Atmelfan/Kandidat/otiPSkB.gif

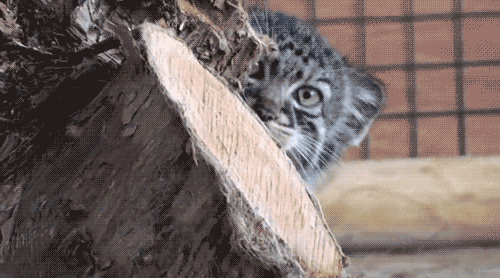
otiPSkB.gif
