Atmelfan/Kandidat/hbridge/hbridge_3d.PNG

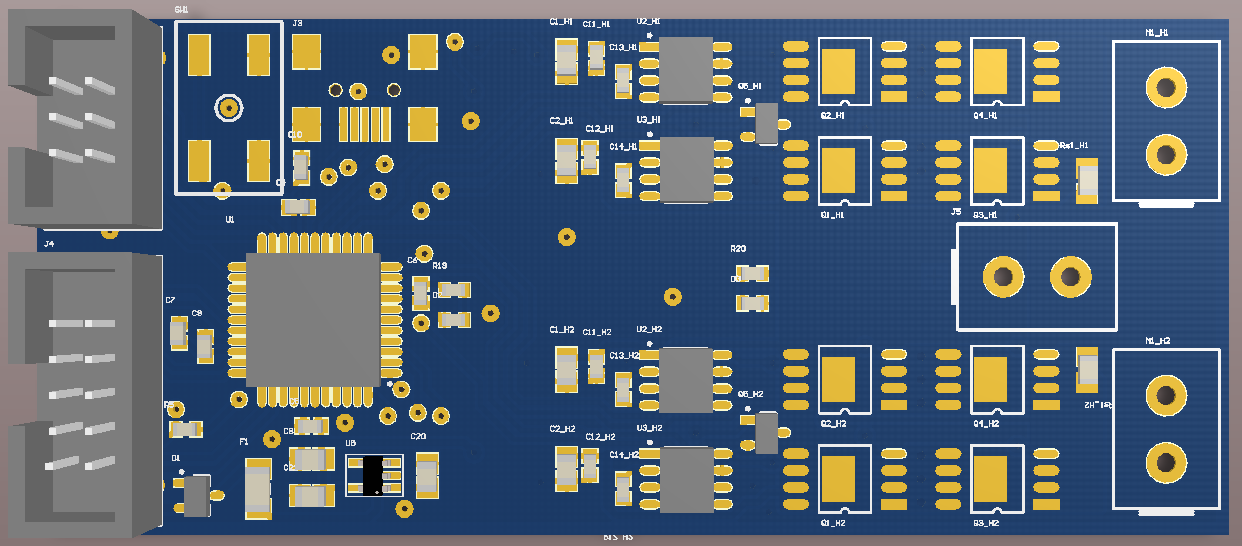
hbridge/hbridge_3d.PNG
