Atmelfan/Kandidat/Capabilities.pdf

## Fabrication limitations and design recommendations

Capability and recommendation matrix, ITN PCB laboratory
Detail | Minimum | Recommended | Maximum
Panel/Board size | Not relevant | < 160 x 160 mm | 210 x 300 mm

Width (conductors):
-Wire/trace | 0.25 mm | 0.5 mm | Not relevant
-Power wire | 0.25 mm | > 1.0 mm | Not relevant

Clearance (conductive):
-Generally | 0.25 mm | 0.6 mm | Not relevant
-Object - Polygon | | 1.0 mm

Other dimensions:
Annular ring VIA | 0.25 mm | >0.4 mm | Not relevant
Annular ring Component | 0.3 mm | >0.6 mm | Not relevant
Drill bit diameter | 0.4 mm | | 5.0 mm
Silkscreen to solder-mask | 0 mm | Not used
Solder mask sliver | 0.2 mm | >0.5 mm | Not relevant
Mill bit diameter | 1.0 mm | 1.5 mm | 2.5 mm
- “Generally means: Trace to trace, pad to pad, pad to trace, i.e., any conducting object that shouldn’t risk being short circuited.
- Object means; trace, pad, i.e., any object not belonging to a polygon plane.
- Annular ring = (diameter of the pad - diameter of the hole) / 2
- Silkscreen to solder-mask (clearance); is not an issue since we don’t print text on the PCB:s in the ITN PCB laboratory. Otherwise it is good to have 0.5 mm margins, and also possibly margins against component keep-out.
- Recommendations are not digital; always consider the particular design. E.g., if a thicker metal is used it is harder to etch small details (Small clearances). Moreover, it is also about probability. One narrow gap that is short is often not as likely as if there are several narrow gaps.
- Some component pads require tight margins, i.e., the footprint must suit the component and exceptions to the above might then be necessary.
- Drill bits are available in 0.1 mm steps, and mill bits are available in 0.5 mm steps. For drill-bits round off upwards if a component has an odd size.
