Atmelfan/Kandidat/hbridge/encoder_3d.png

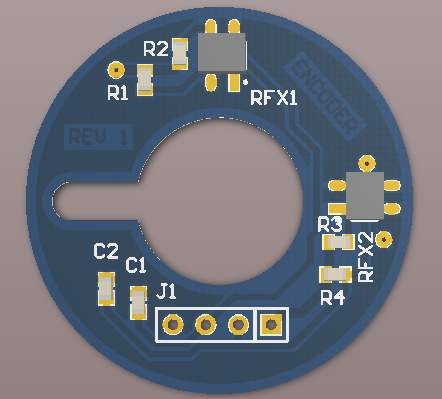
hbridge/encoder_3d.png
