Atmelfan/Kandidat/hbridge/figures/awex.png

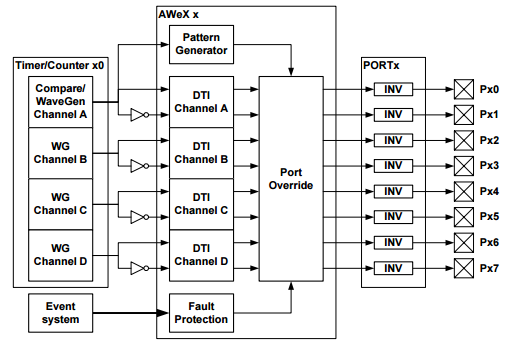
hbridge/figures/awex.png
