Atmelfan/Kandidat/hbridge/figures/bridge.PNG

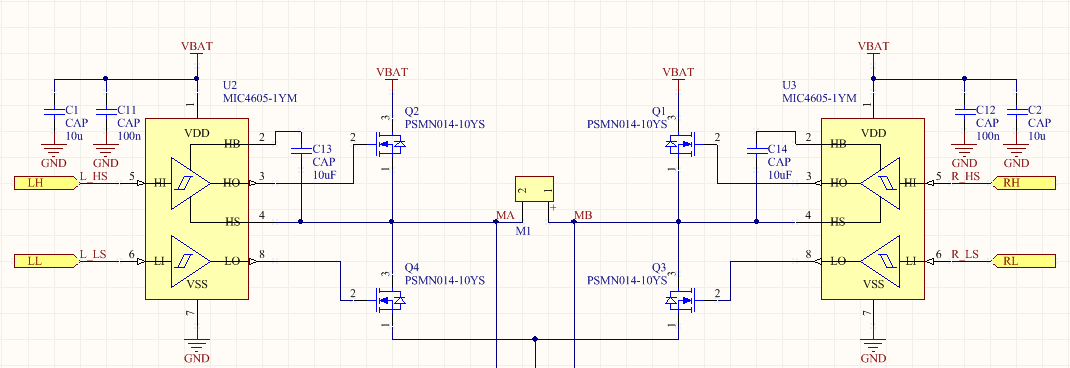
hbridge/figures/bridge.PNG
