Atmelfan/Kandidat/hbridge/figures/c_vs_v.PNG

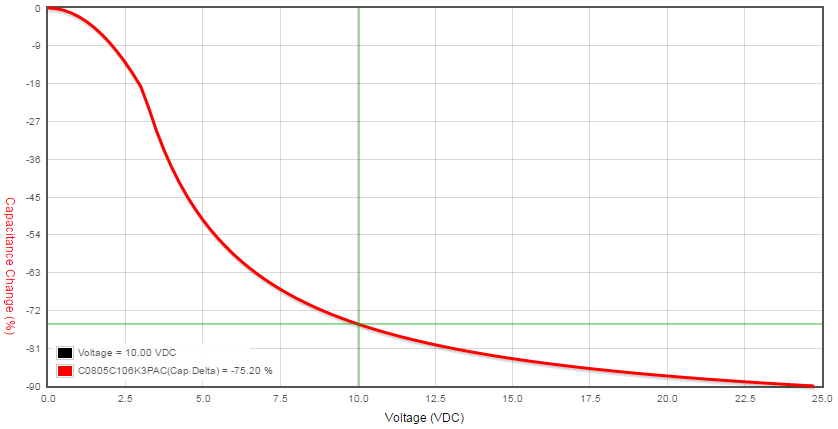
hbridge/figures/c_vs_v.PNG
