Atmelfan/Kandidat/hbridge/Hbridge_PCB_bot.PNG

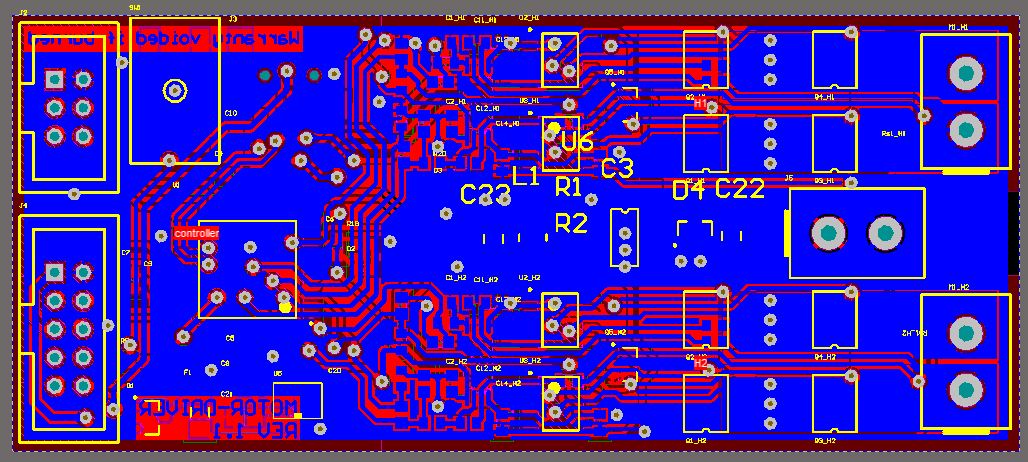
hbridge/Hbridge_PCB_bot.PNG
