Atmelfan/Kandidat/hbridge/Hbridge_PCB_top.PNG

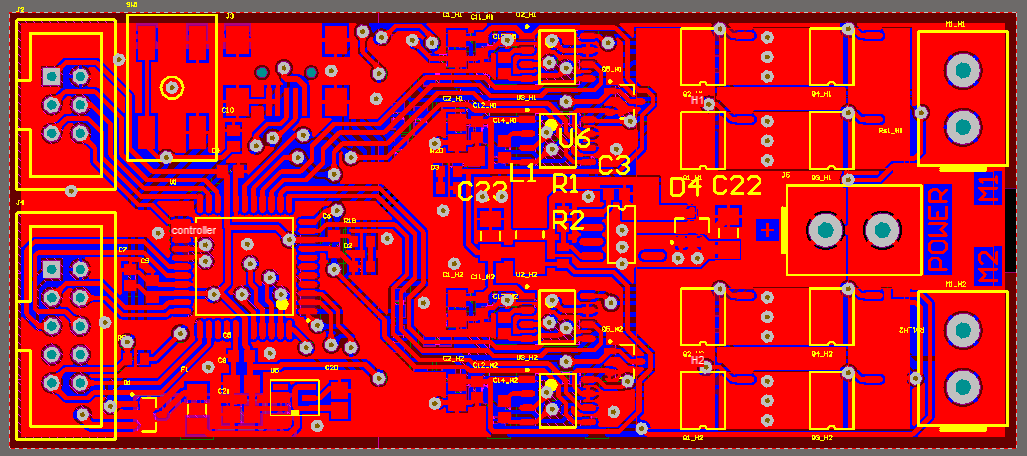
hbridge/Hbridge_PCB_top.PNG
