Atmelfan/Kandidat/hbridge/hbridge_schematic.PNG

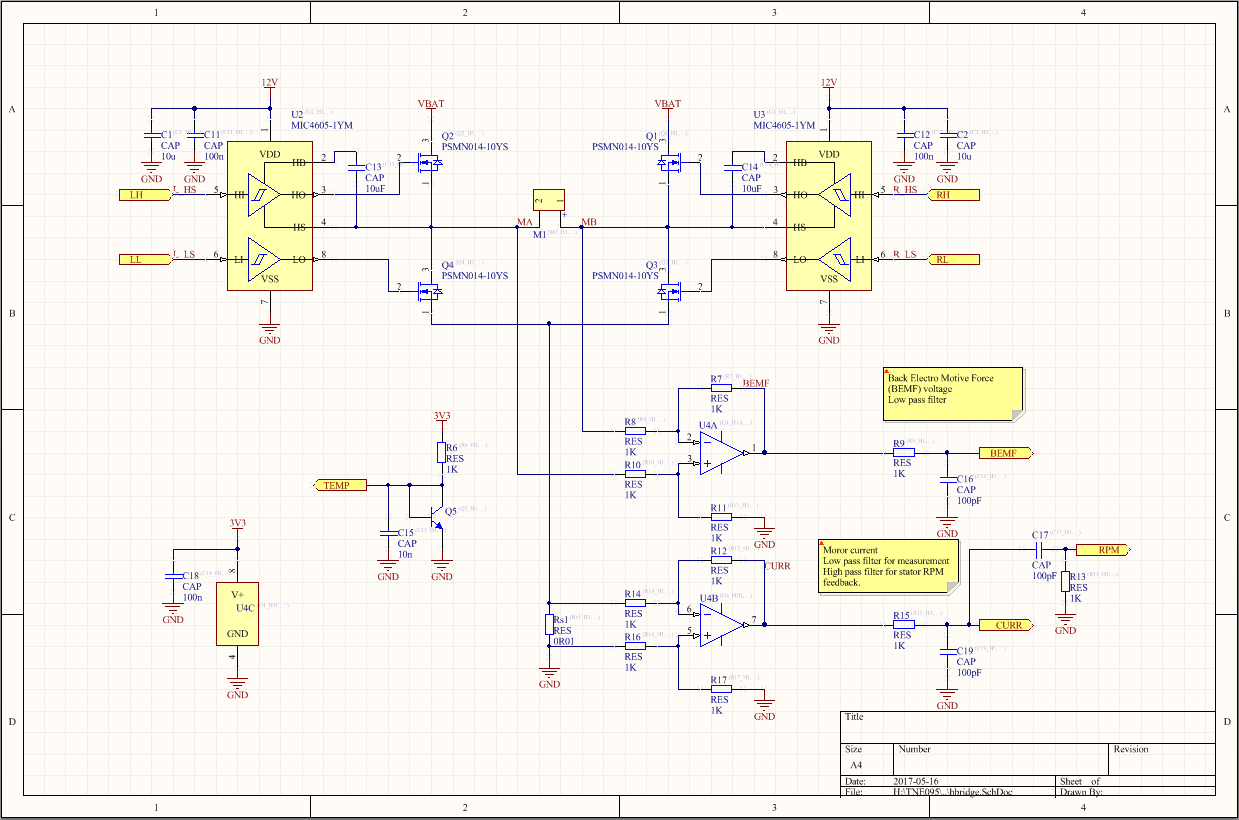
hbridge/hbridge_schematic.PNG
