Atmelfan/Kandidat/hbridge/motor_controller_schematic.PNG

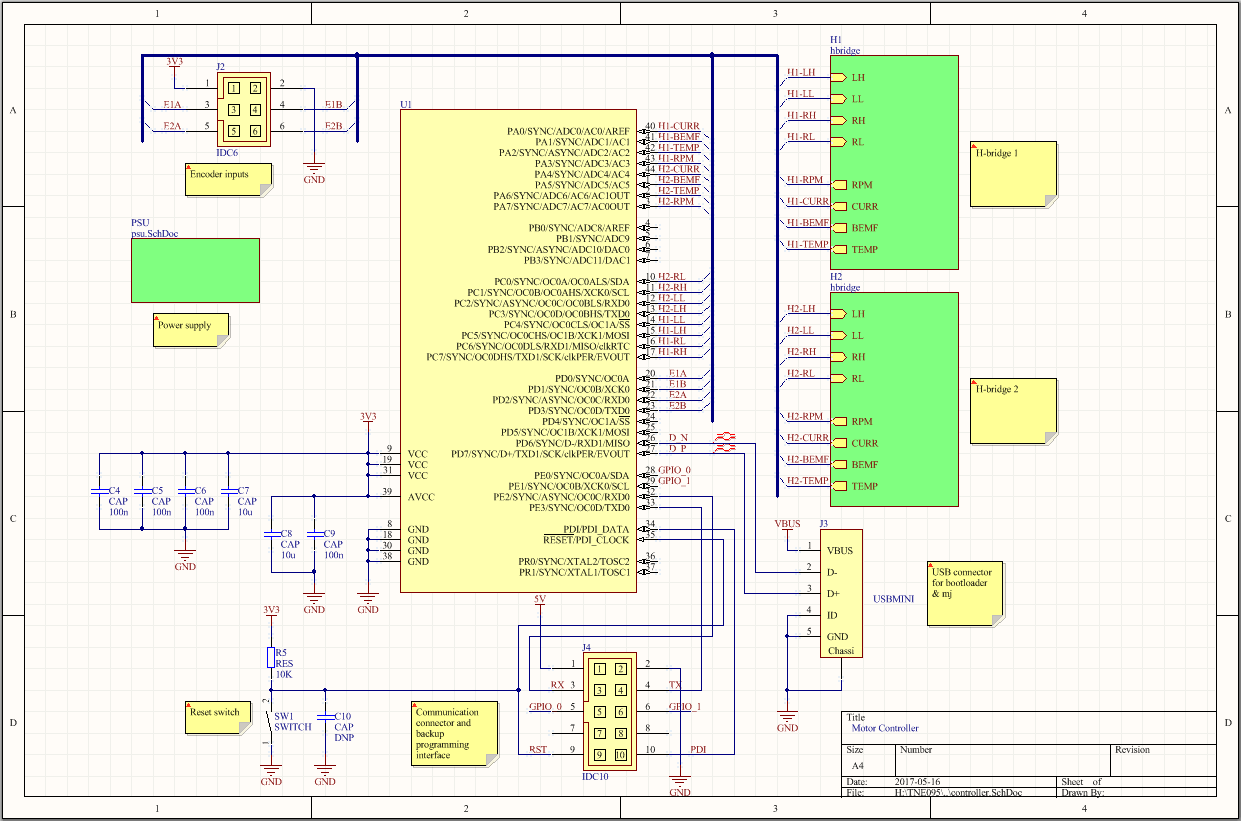
hbridge/motor_controller_schematic.PNG
