Atmelfan/Kandidat/hbridge/psu_schematic.PNG

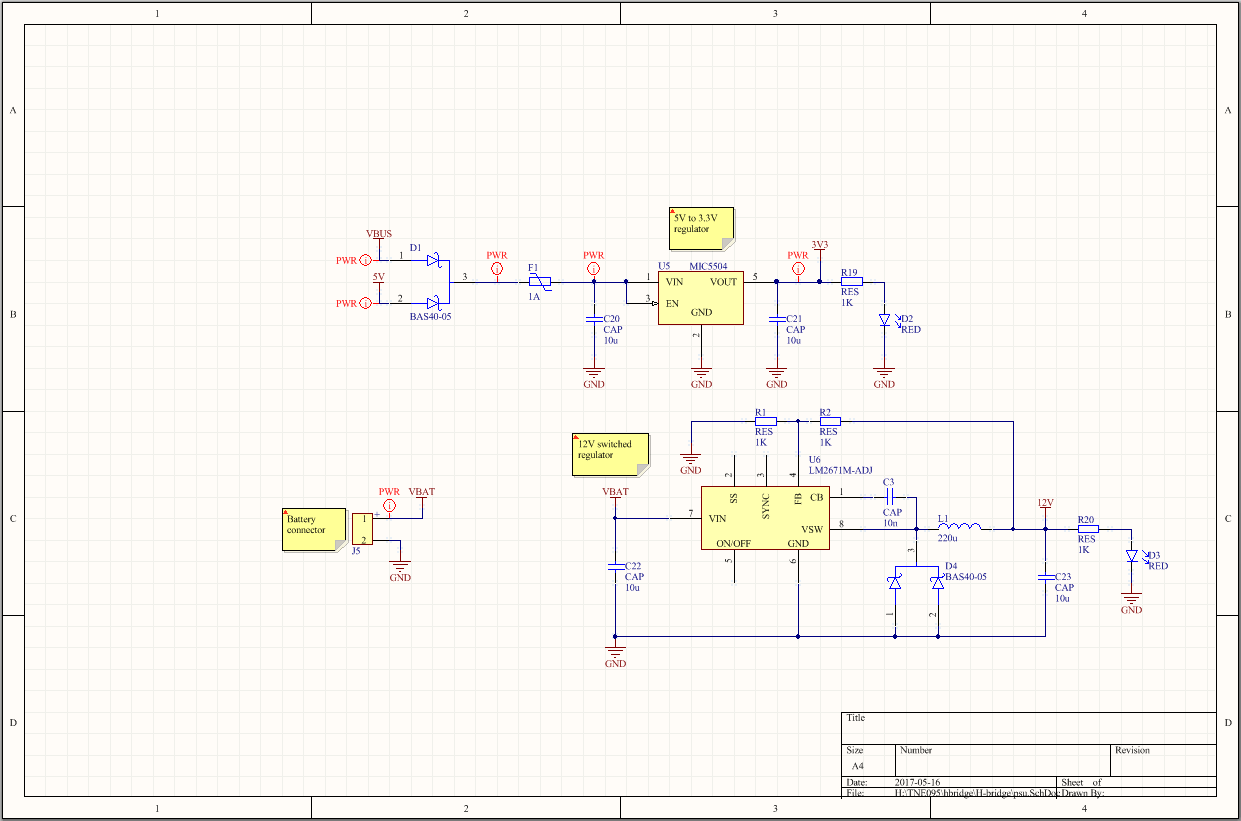
hbridge/psu_schematic.PNG
