Atmelfan/Kandidat/Passenger/Passenger_schematic.PNG

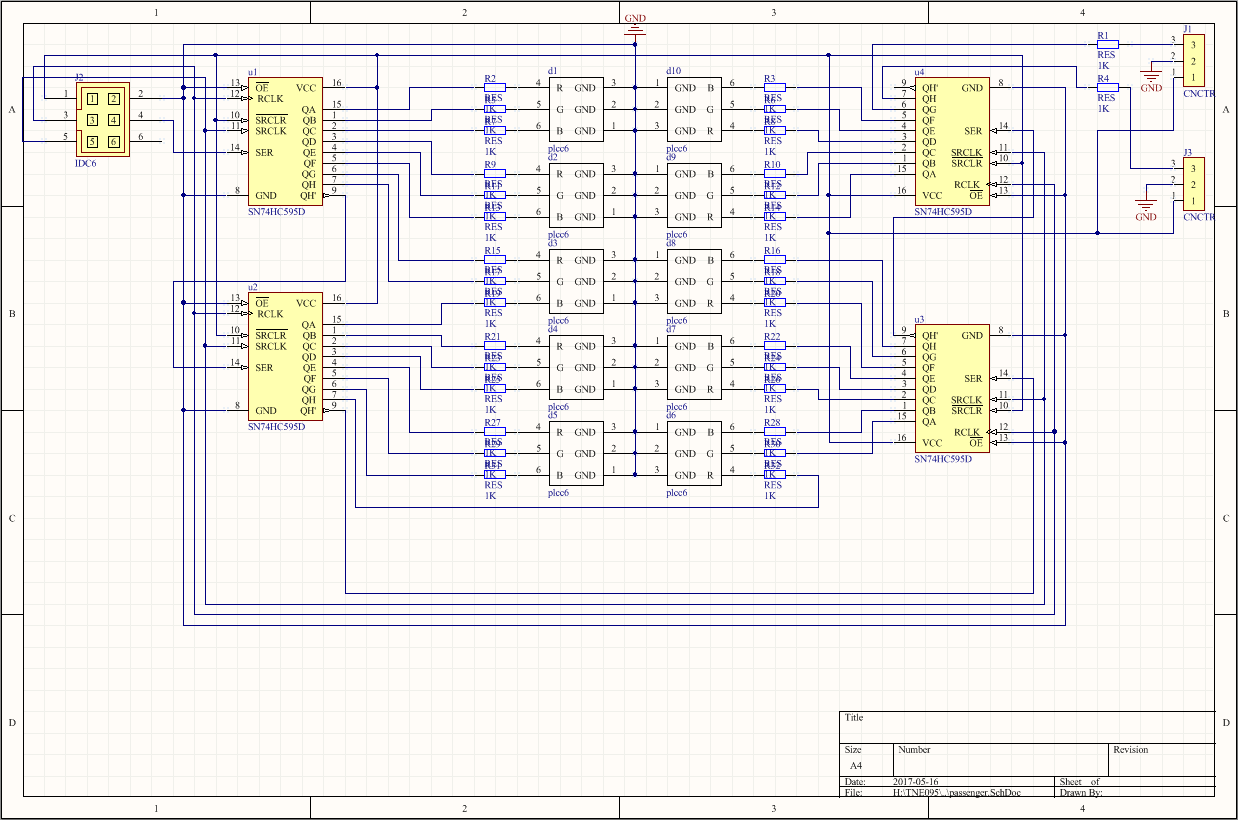
Passenger/Passenger_schematic.PNG
