Atmelfan/Kandidat/reflex/Reflex_PCB.PNG

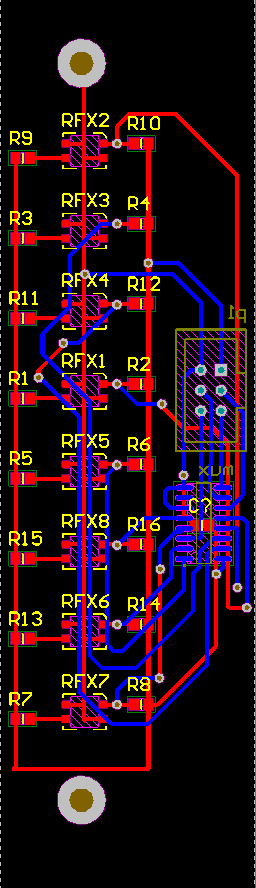
reflex/Reflex_PCB.PNG
