Atmelfan/Kandidat/reflex/Reflex_schematic.PNG

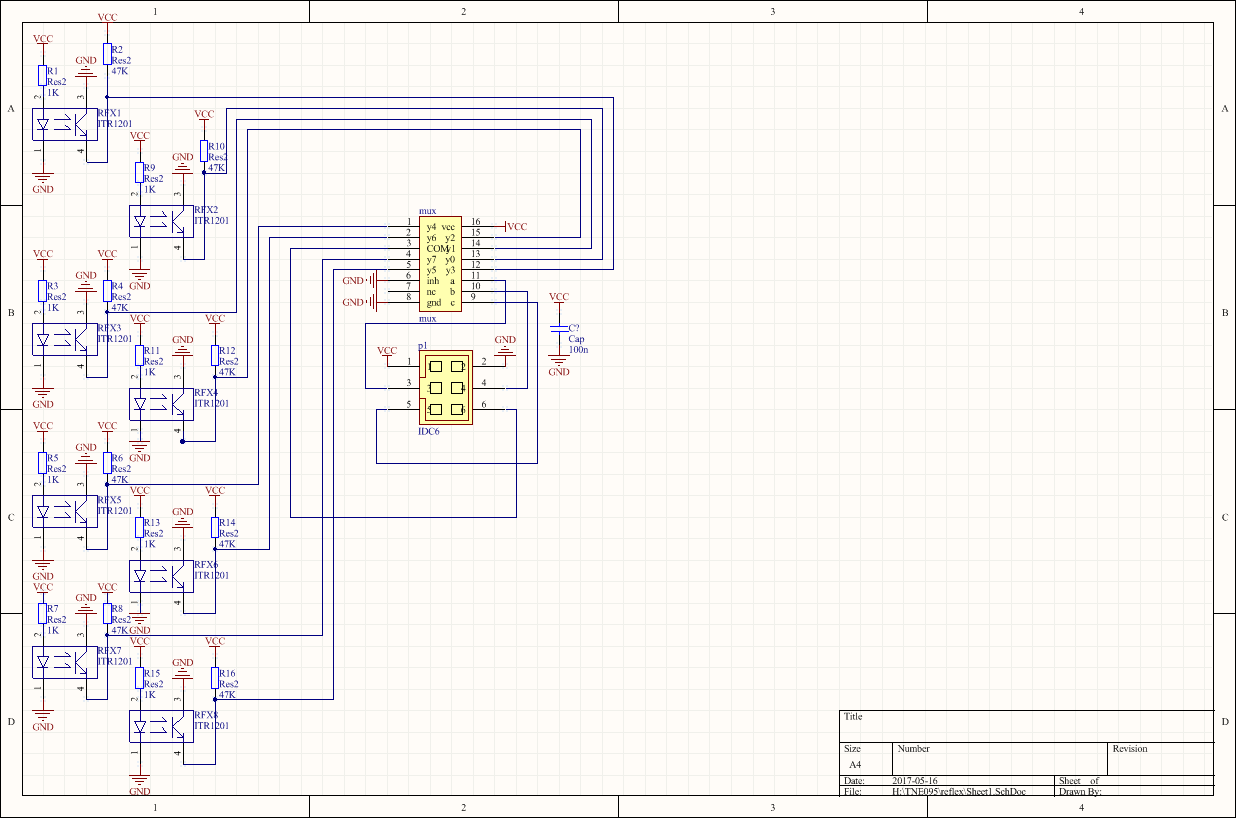
reflex/Reflex_schematic.PNG
