Atmelfan/Kandidat/titor.bmp

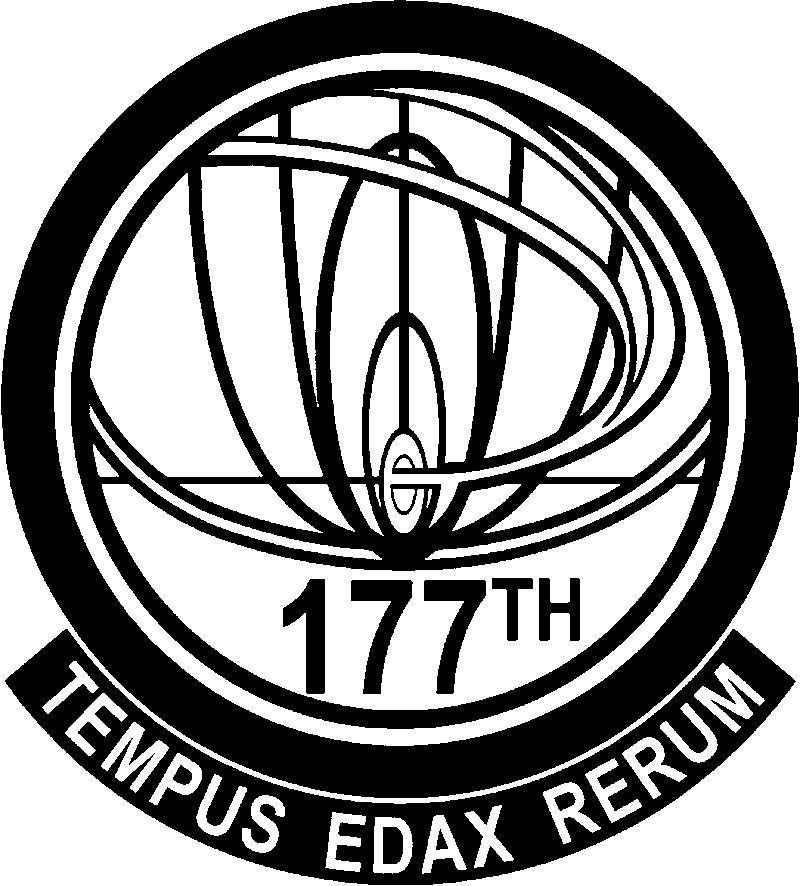
titor.bmp
