Atmelfan/Kandidat/ipc_cap.xls

Sheet: Data
Chip2PinSM | Package Specifications |  |  |  |  |  |  |  |  |  |  |  |  |  |  |  | Footprint Specifications
FootprintName | FootprintDescription | Lmin | Lmax | Wmin | Wmax | Tmin | Tmax | Amin | Amax | PackageType | PolarityPin | DensityLevel | JTmin | JHmin | JSmin | DrawingNote | Z | G | X | Y | C | A | B | R1 | R2 | V1 | V2
C1005[0402] |  | 0.9 | 1.1 | 0.4 | 0.6 | 0.1 | 0.3 |  | 0.6 | C |  | L
C1310[0504] |  | 1.02 | 1.32 | 0.77 | 1.27 | 0.13 | 0.38 |  | 1.02 | C |  | L
C1608[0603] |  | 1.45 | 1.75 | 0.65 | 0.95 | 0.2 | 0.5 |  | 0.85 | C |  | L
C2012[0805] |  | 1.8 | 2.2 | 1.05 | 1.45 | 0.25 | 0.75 |  | 1.1 | C |  | L
C3216[1206] |  | 3 | 3.4 | 1.4 | 1.8 | 0.25 | 0.75 |  | 1.35 | C |  | L
C3225[1210] |  | 3 | 3.4 | 2.3 | 2.7 | 0.25 | 0.75 |  | 1.35 | C |  | L
C4532[1812] |  | 4.2 | 4.8 | 3 | 3.4 | 0.25 | 0.95 |  | 1.35 | C |  | L
C4564[1825] |  | 4.2 | 4.8 | 6 | 6.8 | 0.25 | 0.95 |  | 1.1 | C |  | L

Sheet: Legend - Package
Name | Value Required | Format | Description (Dimensions in mm)
FootprintName | Optional | String | If blank, then auto-generated IPC naming will be used
FootprintDescription | Optional | String | If blank, then description is auto-generated
Lmin, Lmax | Yes | Real | Minimum and maximum body length
Wmin, Wmax | Yes | Real | Minimum and maximum body width
Tmin, Tmax | Yes | Real | Minimum and maximum length of termination
Amin | Optional | Real | Minimum height
Amax | Yes | Real | Maximum height
PackageType | Yes | C, I, R, D | C = Chip Capacitor, I = Chip Inductor, R = Chip Resistor, D = Diode
PolarityPin | Optional | 1, 2 | For capacitors and inductors enter pin number of polarized or positive pin. For diodes enter cathode (-) pin. Leave blank for resistors. Leave blank for inductors and capacitors that have no polarity
DensityLevel | Optional | L, M, N | M = Most or maximum copper (density level A), N = Nominal or median copper (density level B), L = Least or minimum copper (density level C)
JHmin | Optional | Real | Minimum value for heel fillet
JSmin | Optional | Real | Minimum value for side fillet
JTmin | Optional | Real | Minimum value for toe fillet
DrawingNote | Optional | String | If package has other features that will affect the footprint, then enter details.

Sheet: Legend - Footprint
Name | Value Required | Format | Description (Dimensions in mm)
Z | Optional | Real | Distance between pads. Measured from outside edges
G | Optional | Real | Distance between pads. Measured from inside edges
X | Optional | Real | Pad width
Y | Optional | Real | Pad length
C | Optional | Real | Row spacing. Distance between pad centers
A | Optional | Real | Assembly width
B | Optional | Real | Assembly length
V1 | Optional | Real | Courtyard width
V2 | Optional | Real | Courtyard length
R1 | Optional | Real | Silkscreen width
R2 | Optional | Real | Silkscreen length
