Atmelfan/Kandidat/ipc_res.xls

Sheet: Data
Chip2PinSM | Package Specifications |  |  |  |  |  |  |  |  |  |  |  |  |  |  |  | Footprint Specifications
FootprintName | FootprintDescription | Lmin | Lmax | Wmin | Wmax | Tmin | Tmax | Amin | Amax | PackageType | PolarityPin | DensityLevel | JTmin | JHmin | JSmin | DrawingNote | Z | G | X | Y | C | A | B | R1 | R2 | V1 | V2
1005[0402] |  | 1.00 | 1.10 | 0.48 | 0.60 | 0.10 | 0.30 |  | 0.40 | R |  | N
1608[0603] |  | 1.50 | 1.70 | 0.70 | 0.95 | 0.15 | 0.40 |  | 0.60 | R |  | N
2012[0805] |  | 1.85 | 2.15 | 1.10 | 1.40 | 0.15 | 0.65 |  | 0.65 | R |  | N
3216[1206] |  | 3.05 | 3.35 | 1.45 | 1.75 | 0.25 | 0.75 |  | 0.71 | R |  | N
3225[1210] |  | 3.05 | 3.35 | 2.34 | 2.64 | 0.25 | 0.75 |  | 0.71 | R |  | N
5025[2010] |  | 4.85 | 5.15 | 2.35 | 2.65 | 0.35 | 0.85 |  | 0.71 | R |  | N
6332[2512] |  | 4.86 | 6.45 | 3.05 | 3.35 | 0.35 | 0.85 |  | 0.71 | R |  | N

Sheet: Legend - Package
Name | Value Required | Format | Description (Dimensions in mm)
FootprintName | Optional | String | If blank, then auto-generated IPC naming will be used
FootprintDescription | Optional | String | If blank, then description is auto-generated
Lmin, Lmax | Yes | Real | Minimum and maximum body length
Wmin, Wmax | Yes | Real | Minimum and maximum body width
Tmin, Tmax | Yes | Real | Minimum and maximum length of termination
Amin | Optional | Real | Minimum height
Amax | Yes | Real | Maximum height
PackageType | Yes | C, I, R, D | C = Chip Capacitor, I = Chip Inductor, R = Chip Resistor, D = Diode
PolarityPin | Optional | 1, 2 | For capacitors and inductors enter pin number of polarized or positive pin. For diodes enter cathode (-) pin. Leave blank for resistors. Leave blank for inductors and capacitors that have no polarity
DensityLevel | Optional | L, M, N | M = Most or maximum copper (density level A), N = Nominal or median copper (density level B), L = Least or minimum copper (density level C)
JHmin | Optional | Real | Minimum value for heel fillet
JSmin | Optional | Real | Minimum value for side fillet
JTmin | Optional | Real | Minimum value for toe fillet
DrawingNote | Optional | String | If package has other features that will affect the footprint, then enter details.

Sheet: Legend - Footprint
Name | Value Required | Format | Description (Dimensions in mm)
Z | Optional | Real | Distance between pads. Measured from outside edges
G | Optional | Real | Distance between pads. Measured from inside edges
X | Optional | Real | Pad width
Y | Optional | Real | Pad length
C | Optional | Real | Row spacing. Distance between pad centers
A | Optional | Real | Assembly width
B | Optional | Real | Assembly length
V1 | Optional | Real | Courtyard width
V2 | Optional | Real | Courtyard length
R1 | Optional | Real | Silkscreen width
R2 | Optional | Real | Silkscreen length
