Atmelfan/Kandidat/Main_card/Project Outputs for Main_card/Main_card.xls

Sheet: Part List Report
 | Component list |  |  | <Parameter Title not found>
 | Source Data From: |  |  | Main_card.PrjPcb
 | Project: |  |  | Main_card.PrjPcb
 | Variant: |  |  | None
 | Report Date: |  | 2017-03-24 | 16:15:23
 | Print Date: |  | 2017-03-24 | 16:15:28
# | LibRef | #Column Name Error:Manufacturer | #Column Name Error:Manufacturer No | #Column Name Error:PartType | Description | Footprint | #Column Name Error:Package Reference | Quantity
1 | HDR1X4 |  |  |  | 4pin header | HEADER_1X4 |  | 1
2 | POLCAP |  |  |  |  | CAP_FAT |  | 2
3 | CAP |  |  |  | Capacitor | CAPC1608X08M |  | 9
4 | POLCAP |  |  |  |  | CAP_FAT |  | 1
5 | CAP |  |  |  | Capacitor | CAPC2012X11M |  | 2
6 | LED |  |  |  |  | RESC1608X06M |  | 1
7 | LED |  |  |  |  | RESC1608X06M |  | 2
8 | Diode_B530C |  |  |  |  | Diode_B530C |  | 1
9 | IDC10 |  |  |  | 10pin IDC connector | IDC10 |  | 4
10 | POLYFUSE |  |  |  | Polyfuse | RESC3216X07M |  | 1
11 | MOUNT_M3 |  |  |  |  | MOUNT_M3 |  | 4
12 | MINI_USB |  |  |  |  | MINI_USB |  | 1
13 | Connector |  |  |  | 3pin connector | CNCTR_1X3 |  | 3
14 | DR127 |  |  |  |  | DR127 |  | 1
15 | DR127 |  |  |  |  | DR127 |  | 1
16 | RES |  |  |  | Resistor | RESC1608X06M |  | 16
17 | Header 20X2 |  |  |  | Header, 20-Pin, Dual row | HDR2X20 |  | 1
18 | IDC6 |  |  |  | 6pin IDC connector | IDC6 |  | 1
19 | Switch |  |  |  | Switch | Switch_pad |  | 1
20 | TM4C123GH6PM |  |  |  |  | 64A_L |  | 1
21 | LM2596 |  |  |  |  | TO263 |  | 1
22 | MIC5504-3.3 |  |  |  |  | SOT23-5 |  | 1
23 | Quartz HC49US |  |  |  |  | Quartz_HC49US |  | 1
24 | BAT_CNCTR |  |  |  | 2-pin batteri kontakt | BAT_CNCTR |  | 1
Approved |  |  |  | Notes |  |  |  | 58

Sheet: Project Information
Project Full Path | H:\TNE095\Main_card\Main_card.PrjPcb
Project Filename | Main_card.PrjPcb
Variant Name | None
Data-Source Filename | Main_card.PrjPcb
Data-Source Full Path | H:\TNE095\Main_card\Main_card.PrjPcb
Title | <Parameter Title not found>
Total Quantity | 58
Report Time | 16:15:23
Report Date | 2017-03-24
Report Date & Tine | 2017-03-24 16:15:23
Output Name | Bill of Materials
Output Type | BOM_PartType
Output Generator Name | BOM
Output Generator Description | Bill of Materials
