Atmelfan/Kandidat/mek/Assem1.SLDASM

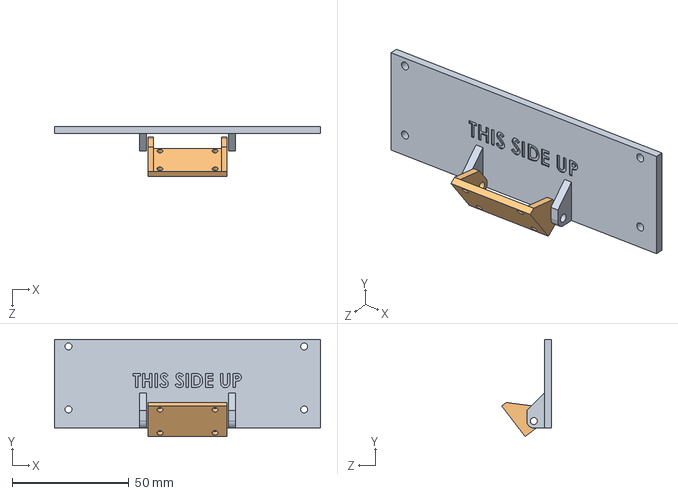
[picture p22: CAD file, 2017-04-09]
mek/Assem1.SLDASM
114.0 x 41.6 x 21.3 mm
front
camera
