Atmelfan/Kandidat/hbridge/H-bridge/hbridge.SLDPRT

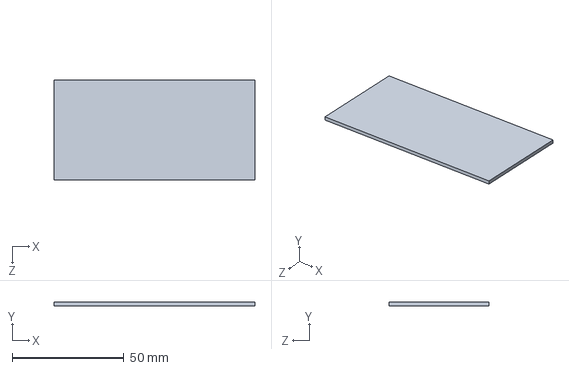
[picture p23: CAD file, 2017-03-28]
hbridge/H-bridge/hbridge.SLDPRT
90.0 x 1.60 x 45.0 mm
