Atmelfan/Kandidat/mek/camera.SLDPRT

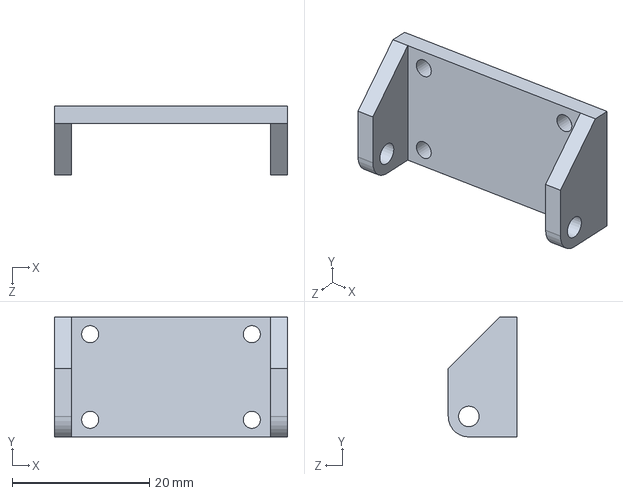
[picture p24: CAD file, 2017-04-09]
mek/camera.SLDPRT
34.0 x 17.5 x 10.0 mm
