Atmelfan/Kandidat/solidworks/reg2.SLDPRT

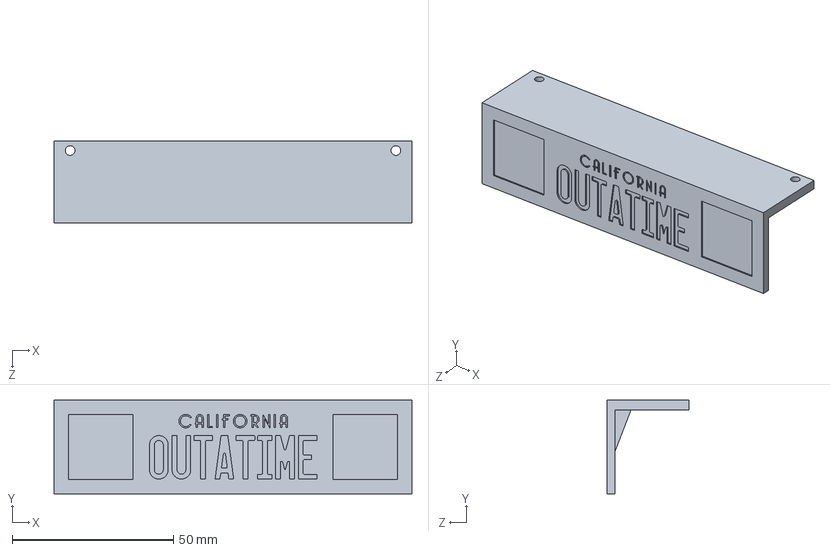
[picture p25: CAD file, 2017-03-27]
solidworks/reg2.SLDPRT
111.0 x 29.0 x 25.5 mm
