Atmelfan/Kandidat/hbridge/encoder/encoder.STEP

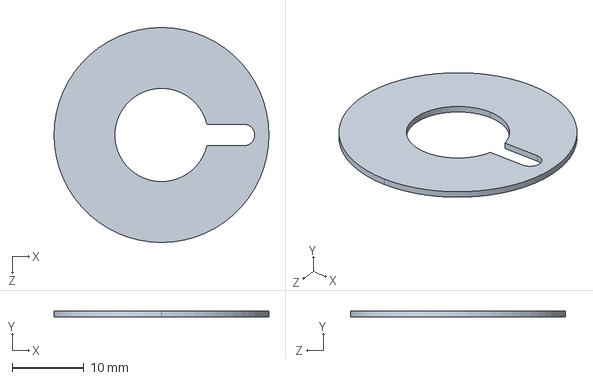
[picture p26: CAD file, 2017-03-27]
hbridge/encoder/encoder.STEP
30.0 x 0.8 x 30.0 mm
