Atmelfan/Kandidat/mek/holder.SLDPRT

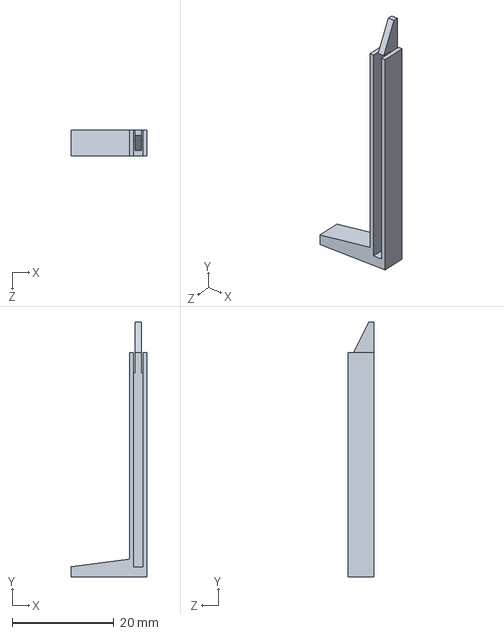
[picture p27: CAD file, 2017-04-09]
mek/holder.SLDPRT
15.0 x 50.0 x 5.00 mm
