Atmelfan/Kandidat/mek/front.SLDPRT

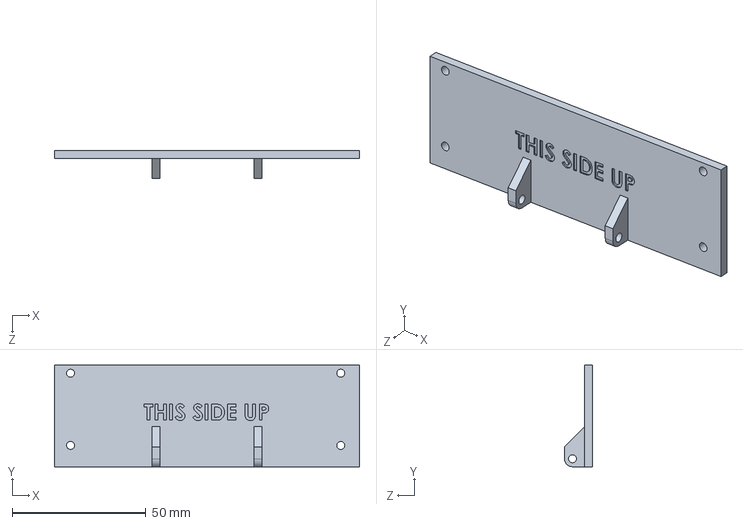
[picture p28: CAD file, 2017-04-09]
mek/front.SLDPRT
114.0 x 38.0 x 10.5 mm
