Atmelfan/Kandidat/mek/irsens.SLDPRT

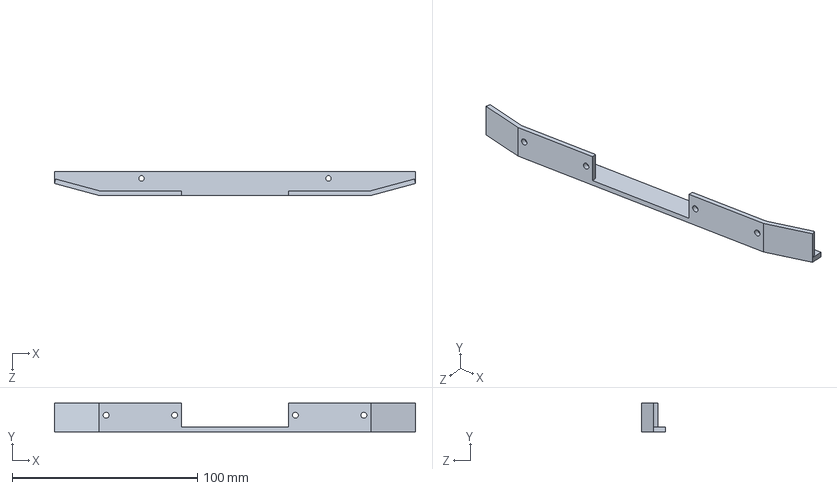
[picture p29: CAD file, 2017-04-09]
mek/irsens.SLDPRT
195.0 x 15.5 x 13.0 mm
