Atmelfan/Kandidat/(list of files, cad)

Other CAD files:
hbridge/encoder/altium_encoder.DXF
solidworks/reg2_tb1337.SLDPRT
hbridge/encoder/encoder.DXF
hbridge/encoder/encoder.SLDPRT
hbridge/encoder/encoder.STL
mek/camera.STL
mek/front.STL
mek/holder.STL
mek/irsens.STL
solidworks/reg2.SLDDRW
solidworks/reg2_tb1337.STL
