Atmelfan/Kandidat/raspberry/performance.txt

1640x922@mode=0, framerate=20, at = 0.24s, []
1640x922@mode=0, framerate=60, at = ~0.195082s, mp on, [] #(+18%)

1640x922@mode=0, framerate=60
dt=0.21915912628173828, at = 0.233563, pt = 0.076631, []

1640x922@mode=0, framerate=40
dt=0.22432231903076172, at = 0.232095, pt = 0.072800, []

1280x720@mode=0, framerate=24
dt=0.16910457611083984, at = 0.167487, pt = 0.046737, []

1024x576@mode=0, framerate=24
dt=0.1259901523590088, at = 0.124503, pt = 0.029007, []
