Atmelfan/Kandidat/hbridge/hbridge.pdf

# CAP2

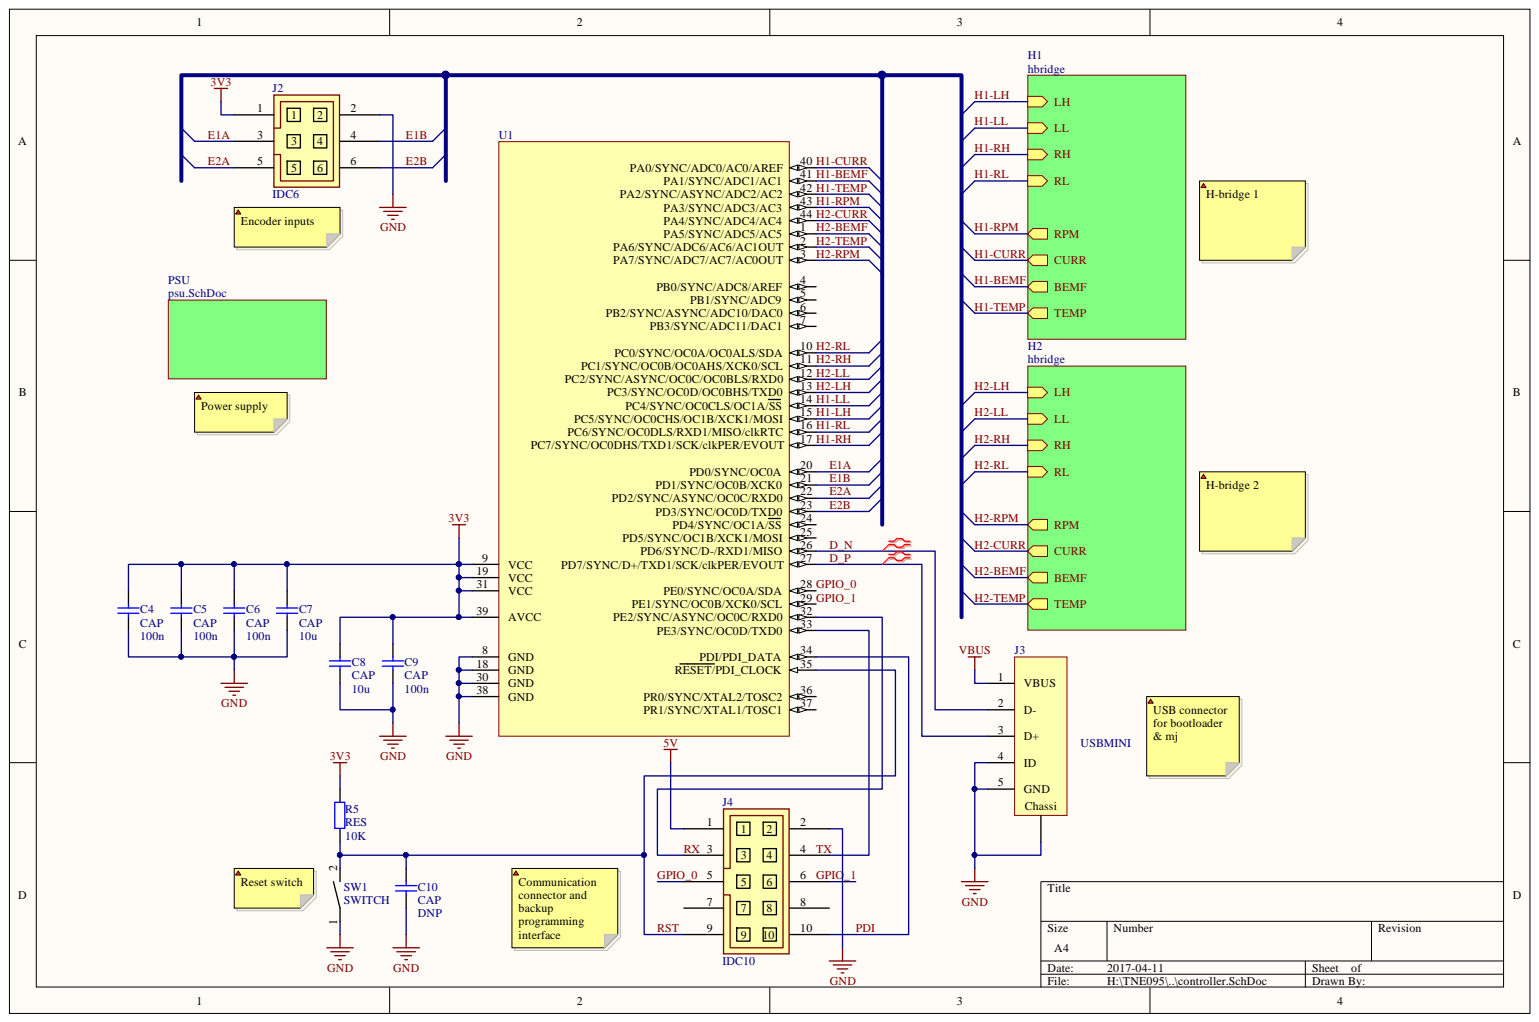
[picture p30: page 1]

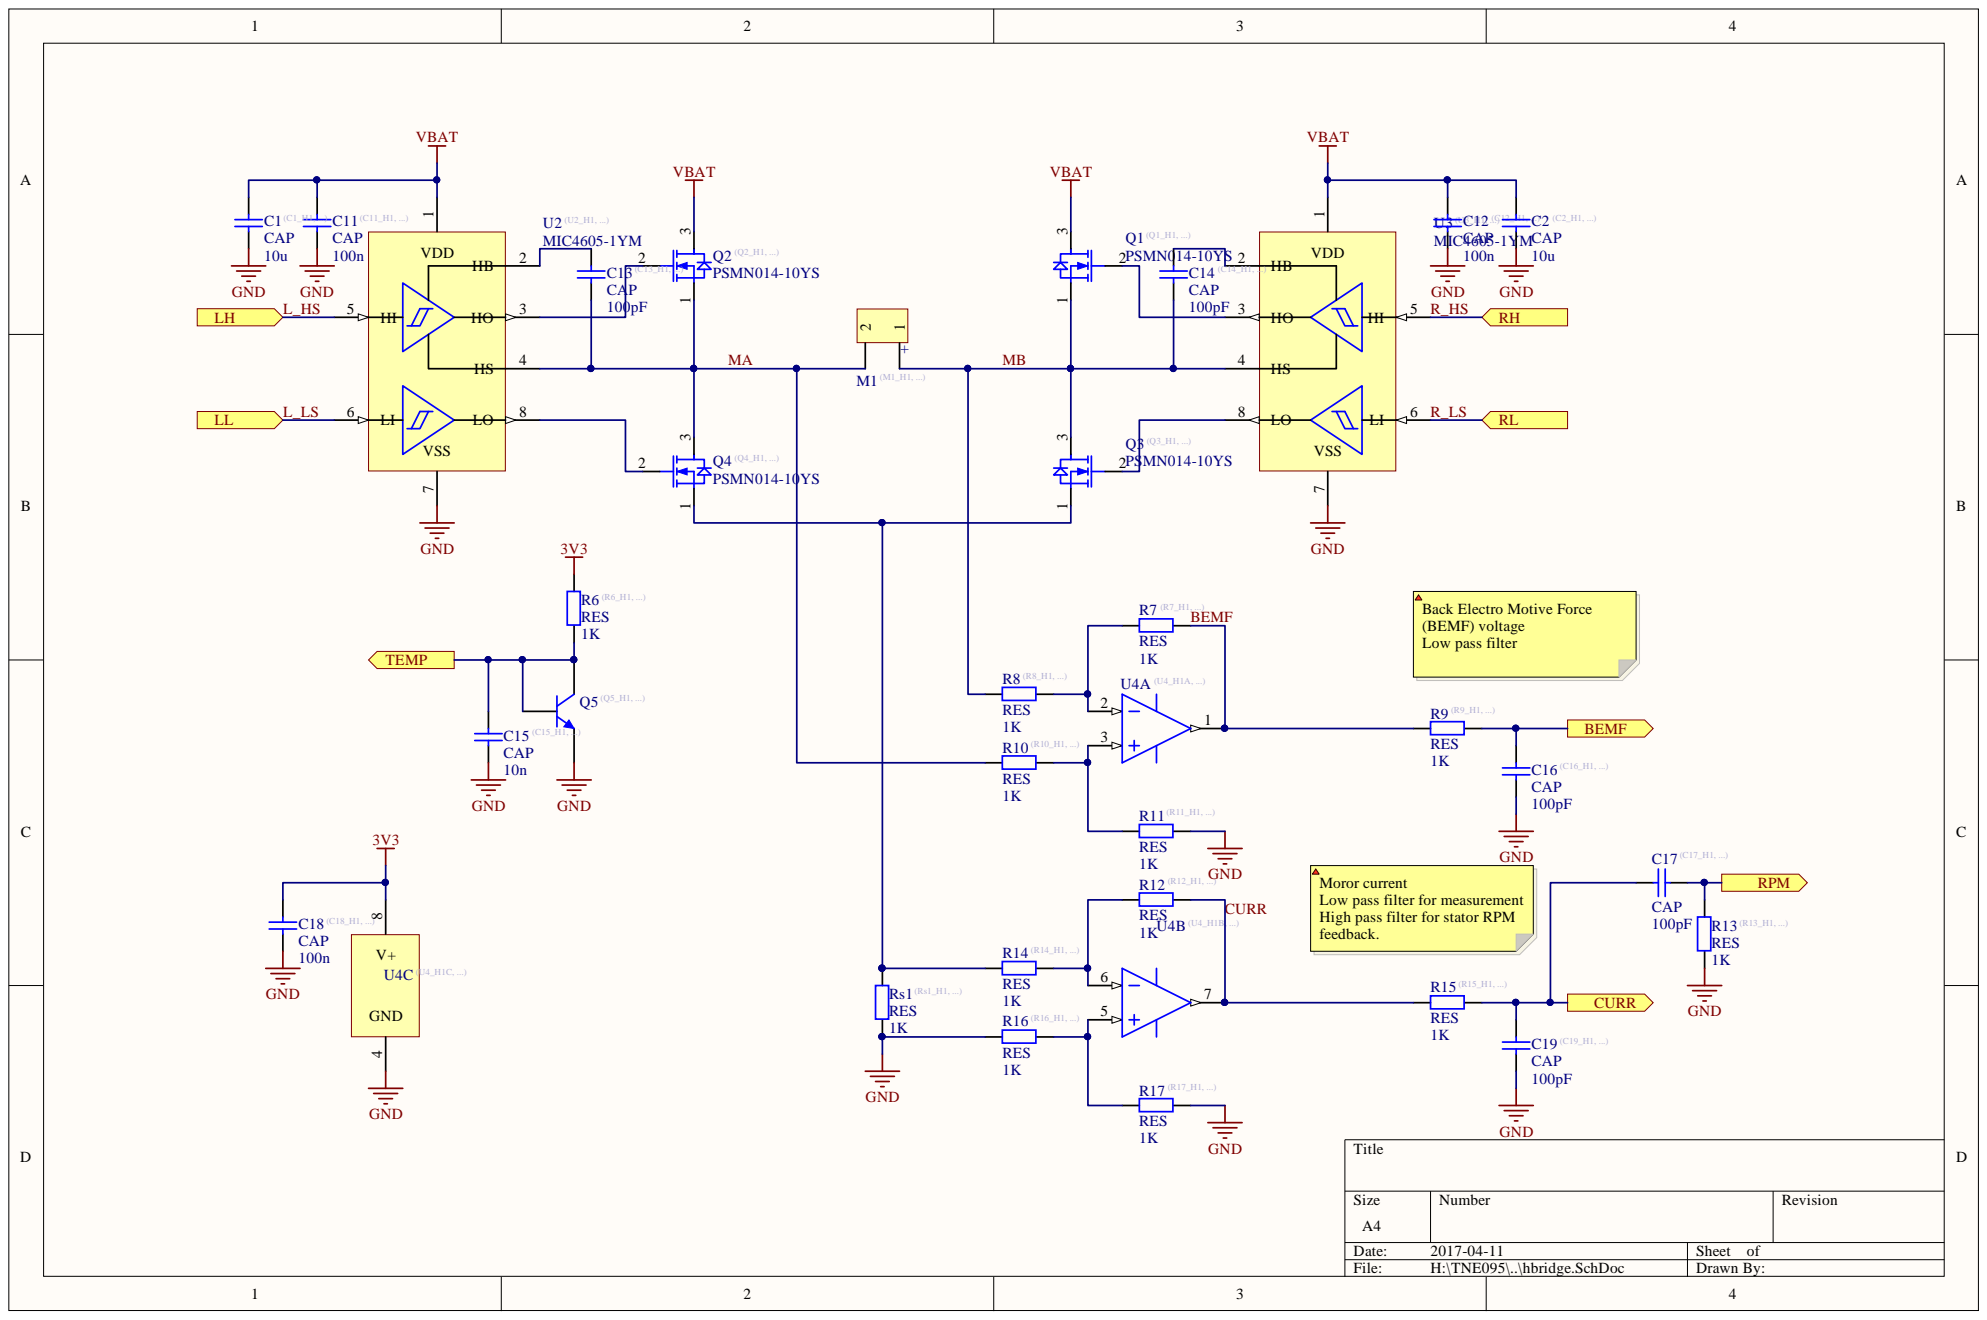
[picture p31: page 2]

Back Electro Motive Force
(BEMF) voltage
Low pass filter

Moror current
Low pass filter for measurement
High pass filter for stator RPM
feedback.

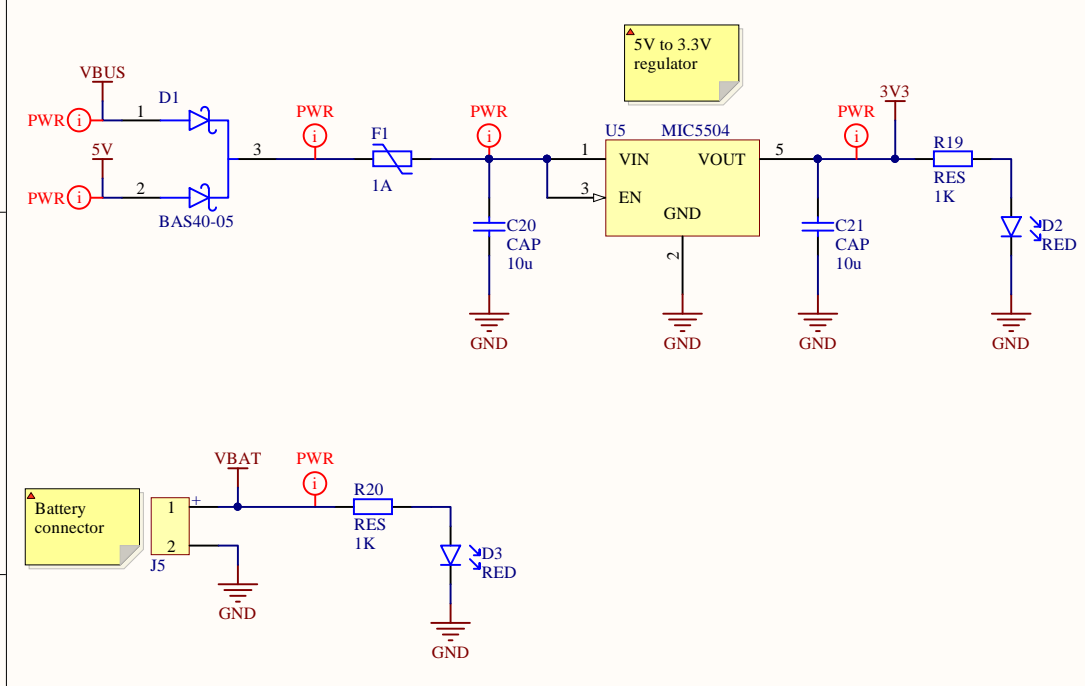
[picture p32: page 3]
