Atmelfan/Kandidat/solidworks/reg2.PDF

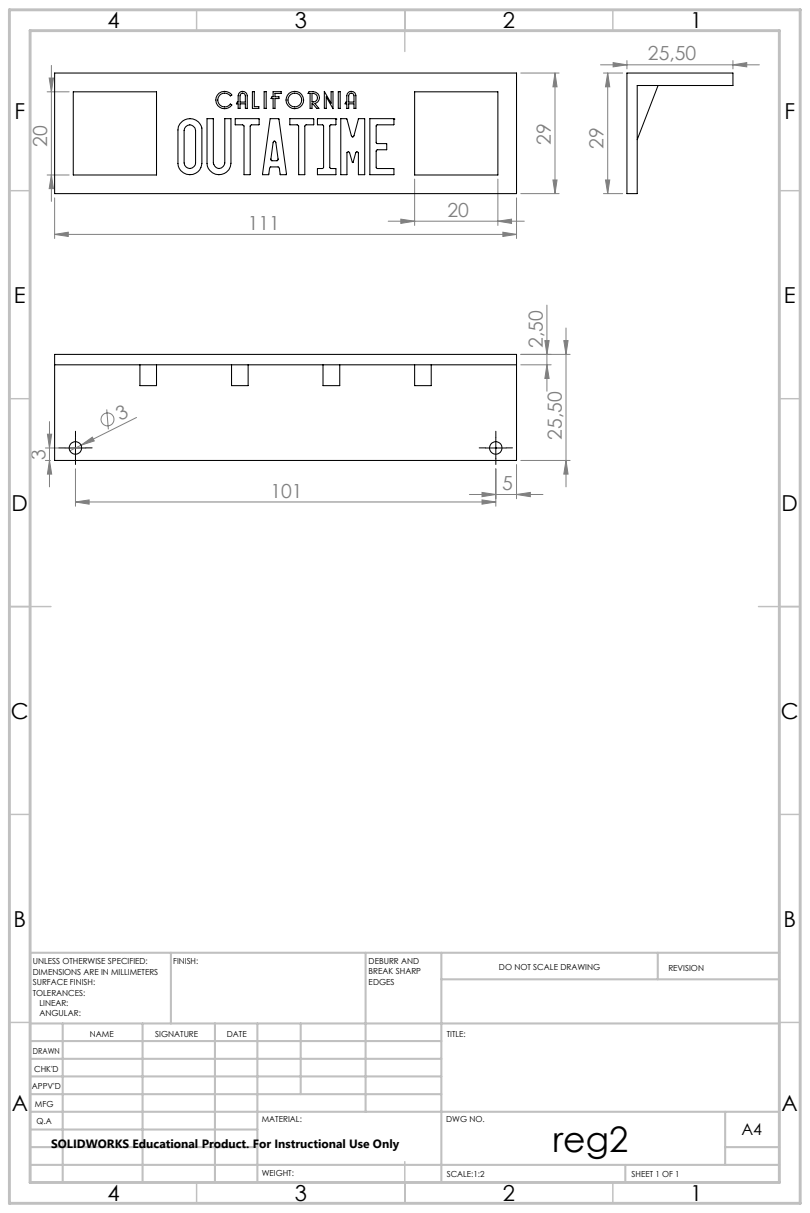
[picture p33: page 1]
FINISH:; DEBURR AND; BREAK SHARP; DO NOT SCALE DRAWING; REVISION

UNLESS OTHERWISE SPECIFIED:
DIMENSIONS ARE IN MILLIMETERS
SURFACE FINISH:
TOLERANCES:
LINEAR:
ANGULAR:

NAME | SIGNATURE | DATE | | | | TITLE:

DRAWN
CHK'D
APPV'D
MFG
Q.A | | | | MATERIAL: | DWG NO. reg2 | A4
SOLIDWORKS Educational Product. For Instructional Use Only

WEIGHT: | | SCALE:1:2 | SHEET 1 OF 1
