Atmelfan/Kandidat/hbridge/H-bridge/H-bridge.pdf

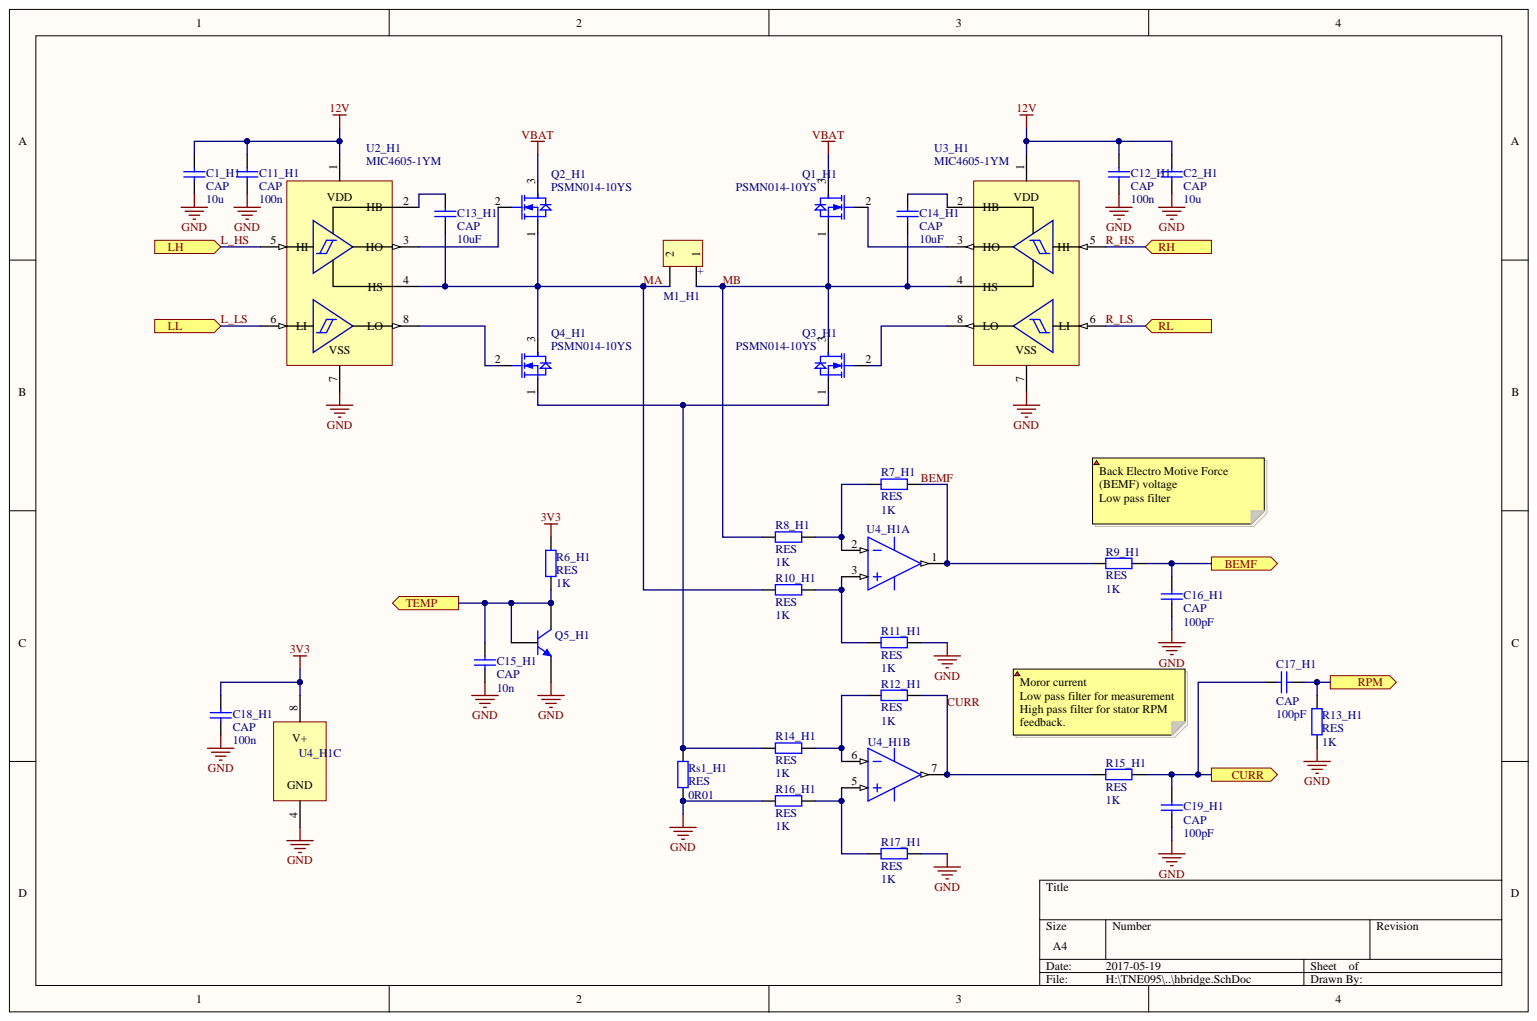
[picture p34: page 1]

Back Electro Motive Force
(BEMF) voltage
Low pass filter

Moror current
Low pass filter for measurement
High pass filter for stator RPM
feedback.

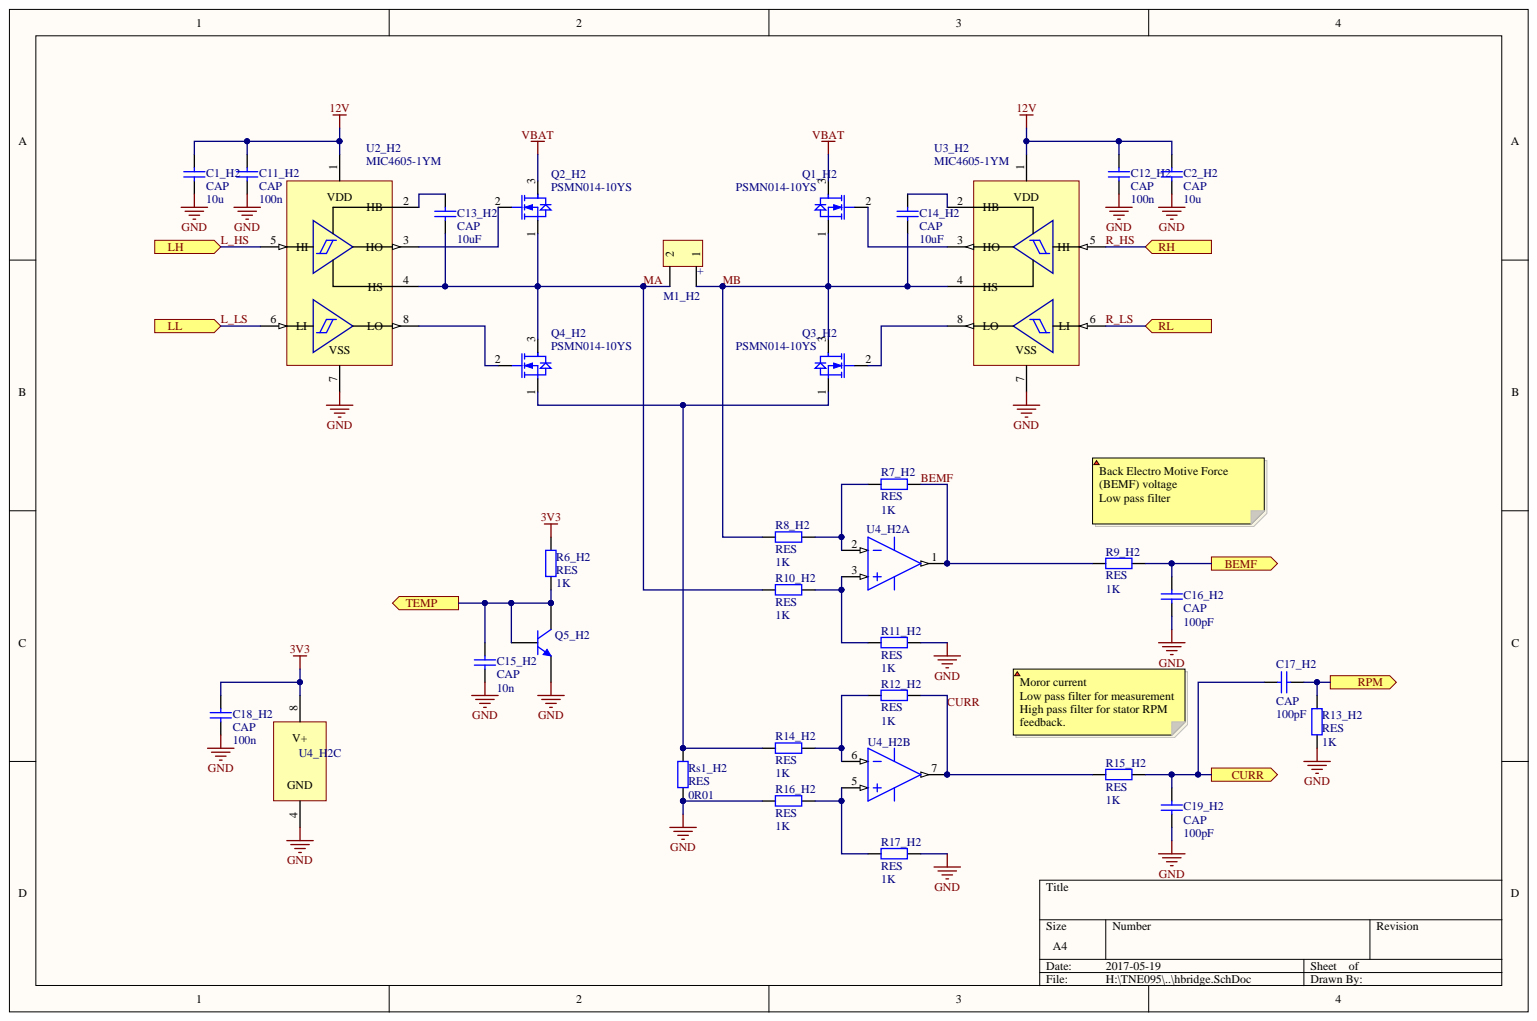
[picture p35: page 2]

Back Electro Motive Force
(BEMF) voltage
Low pass filter

Moror current
Low pass filter for measurement
High pass filter for stator RPM
feedback.

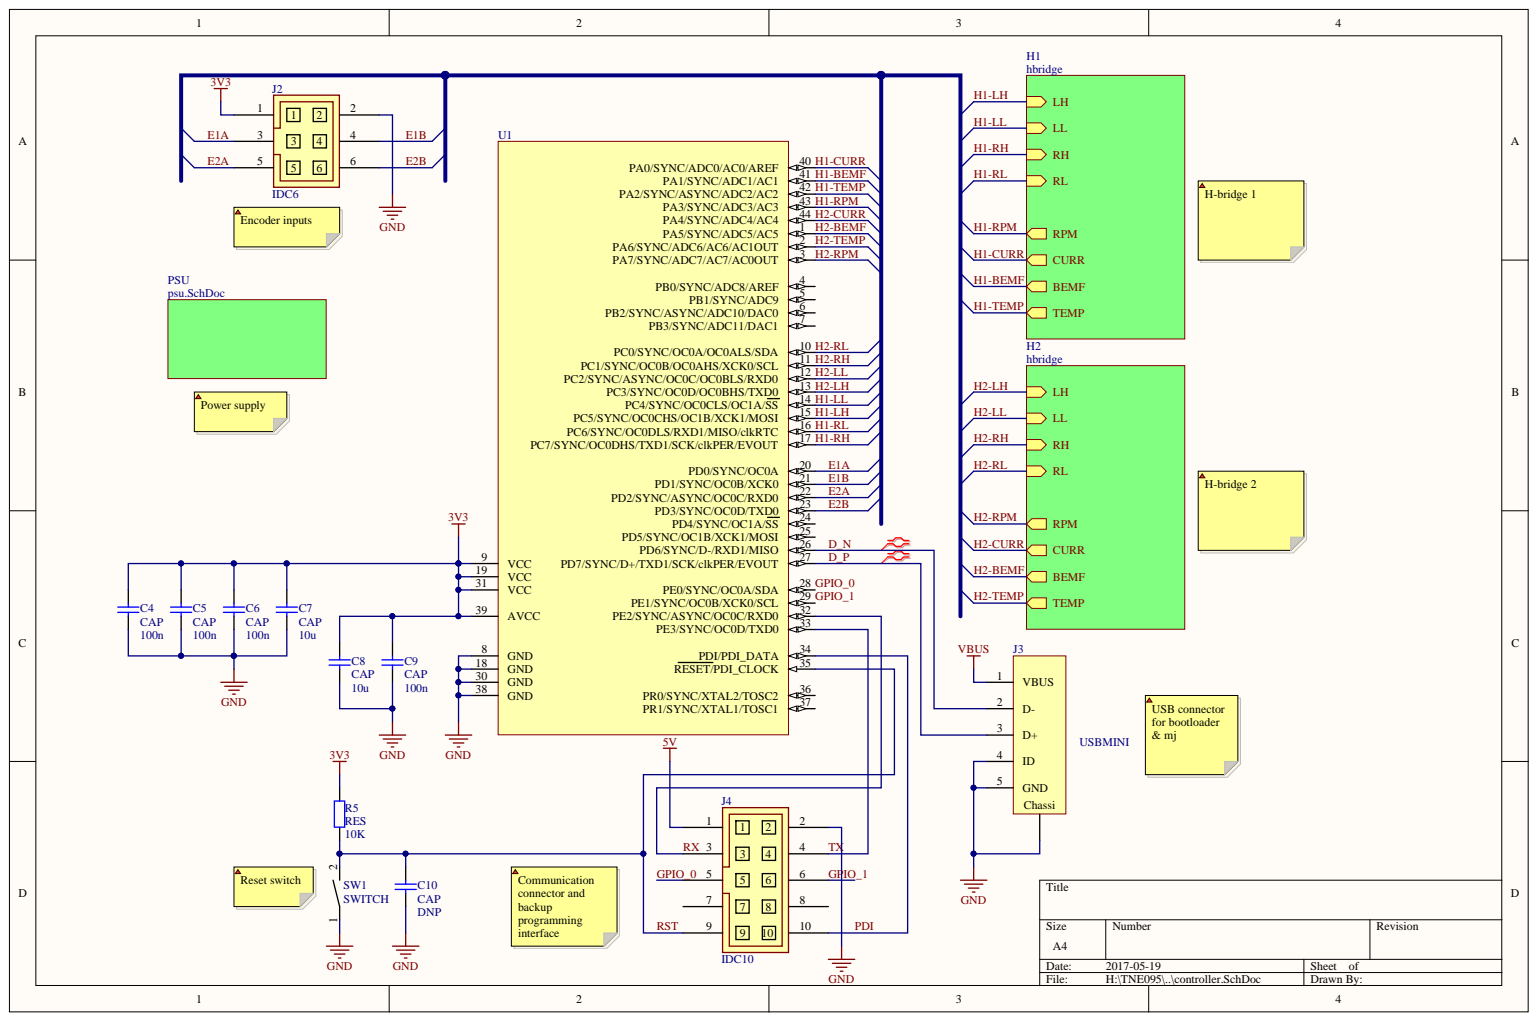
[picture p36: page 3]

E1A | H2-RL
E1B | H2-RPM

D_P | H2-BEMF

VCC 19 | | GPIO_0 GPIO_1

AVCC 39

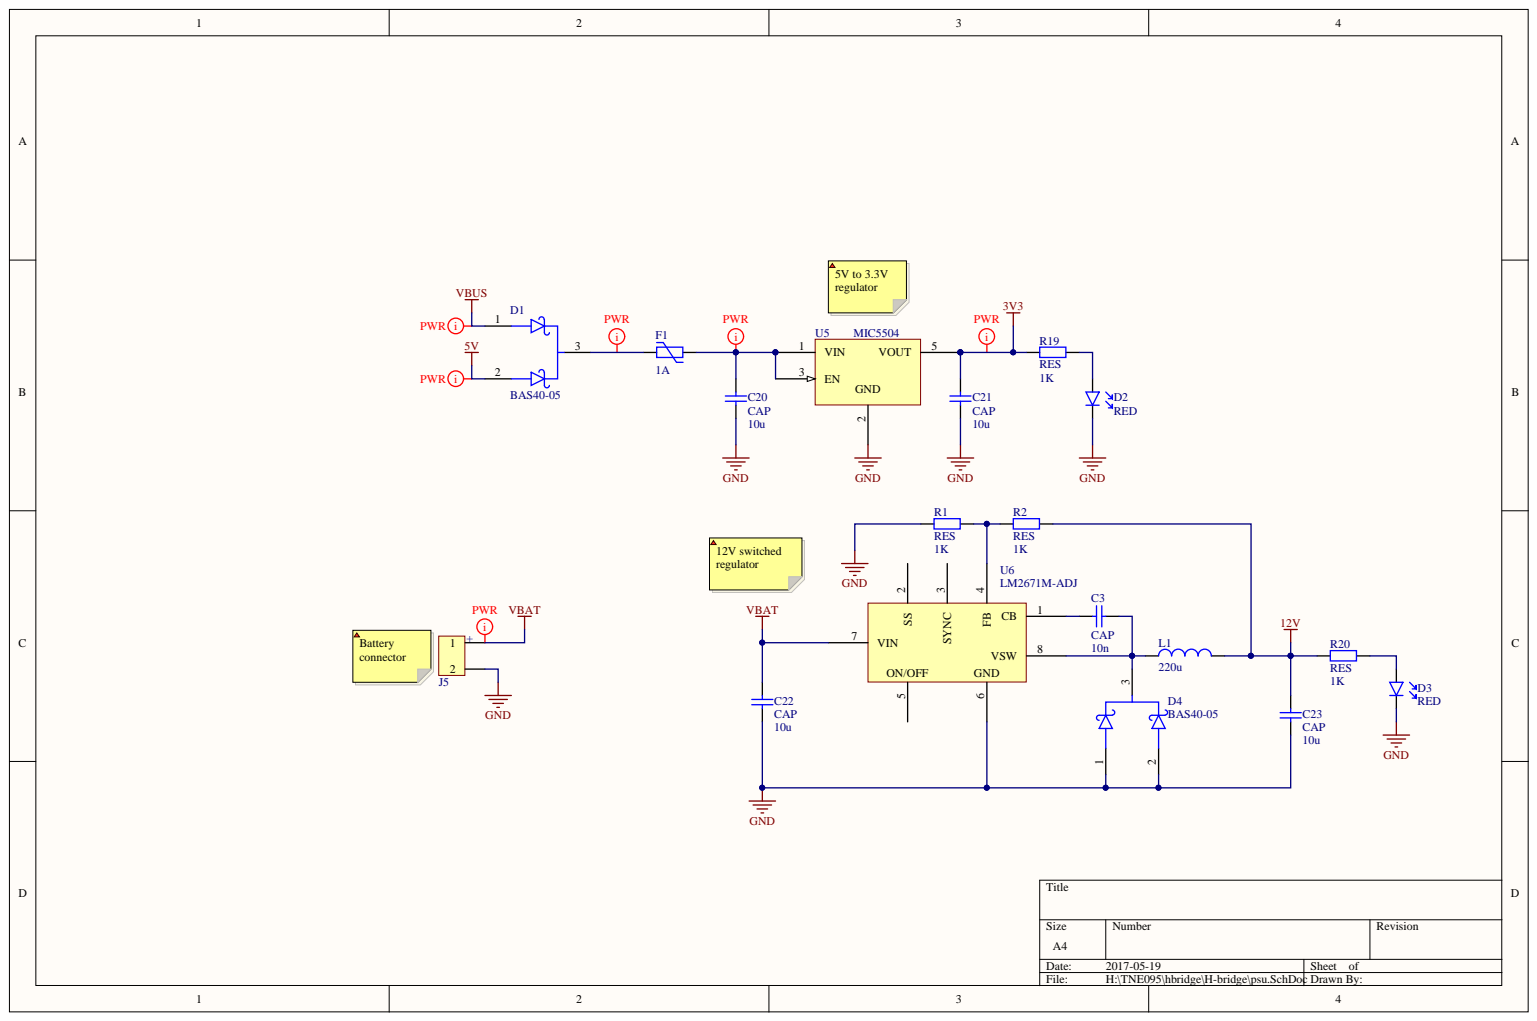
[picture p37: page 4]
