Atmelfan/Kandidat/hbridge/H-bridge/H-bridge_l.pdf

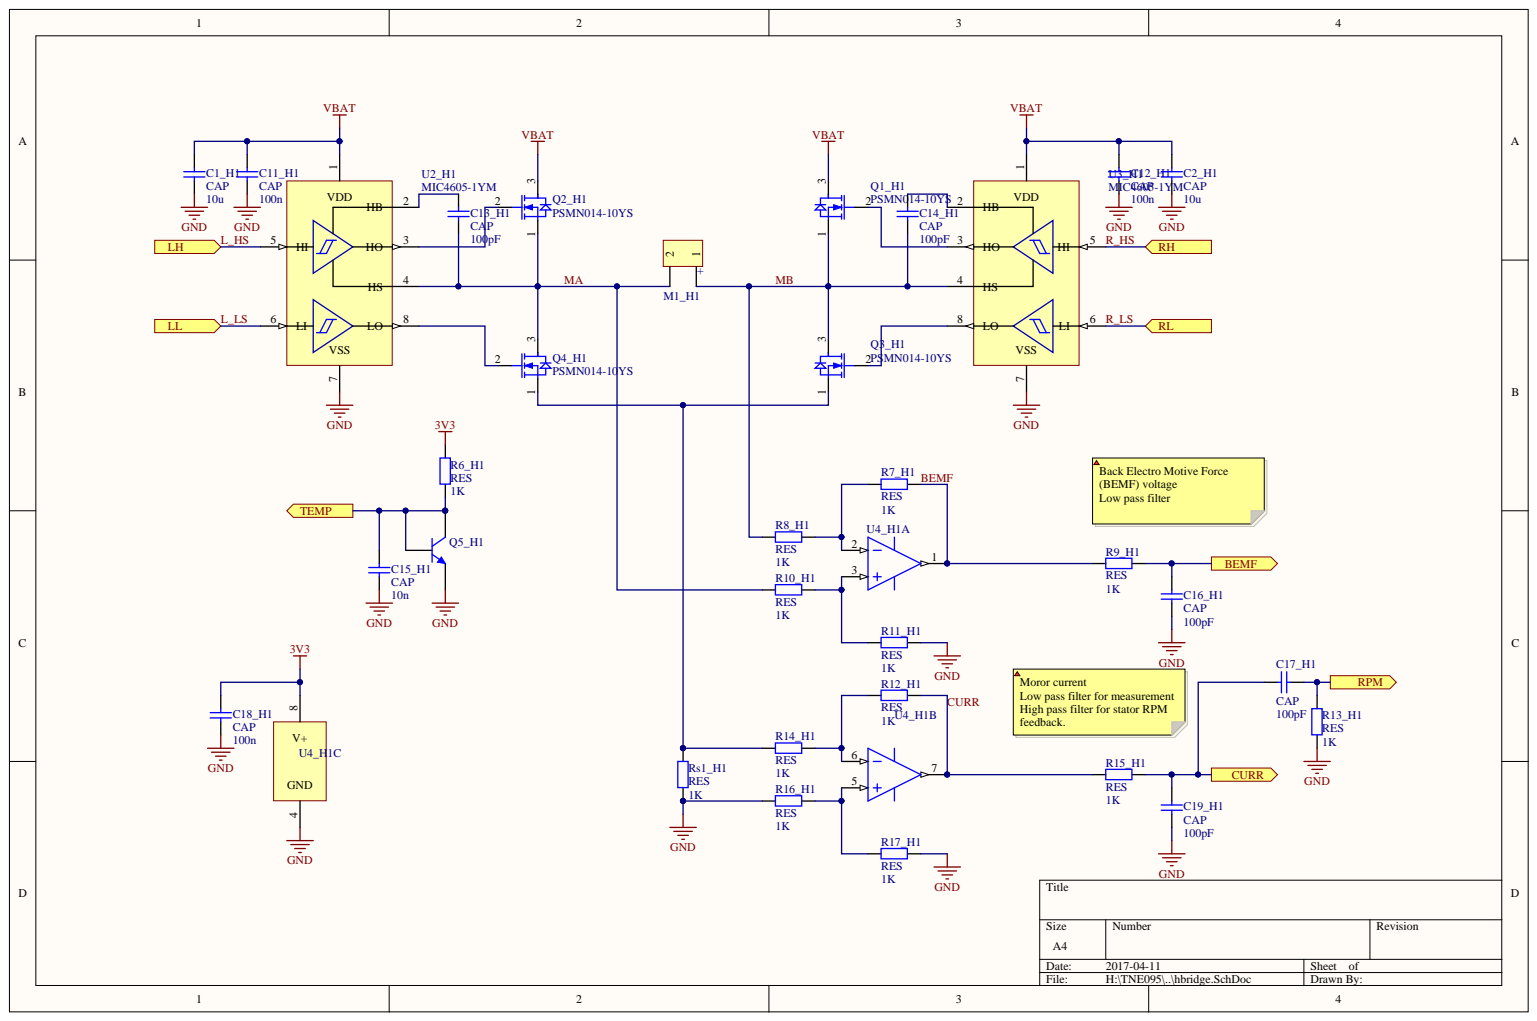
[picture p38: page 1]

Back Electro Motive Force
(BEMF) voltage
Low pass filter

Moror current
Low pass filter for measurement
High pass filter for stator RPM
feedback.

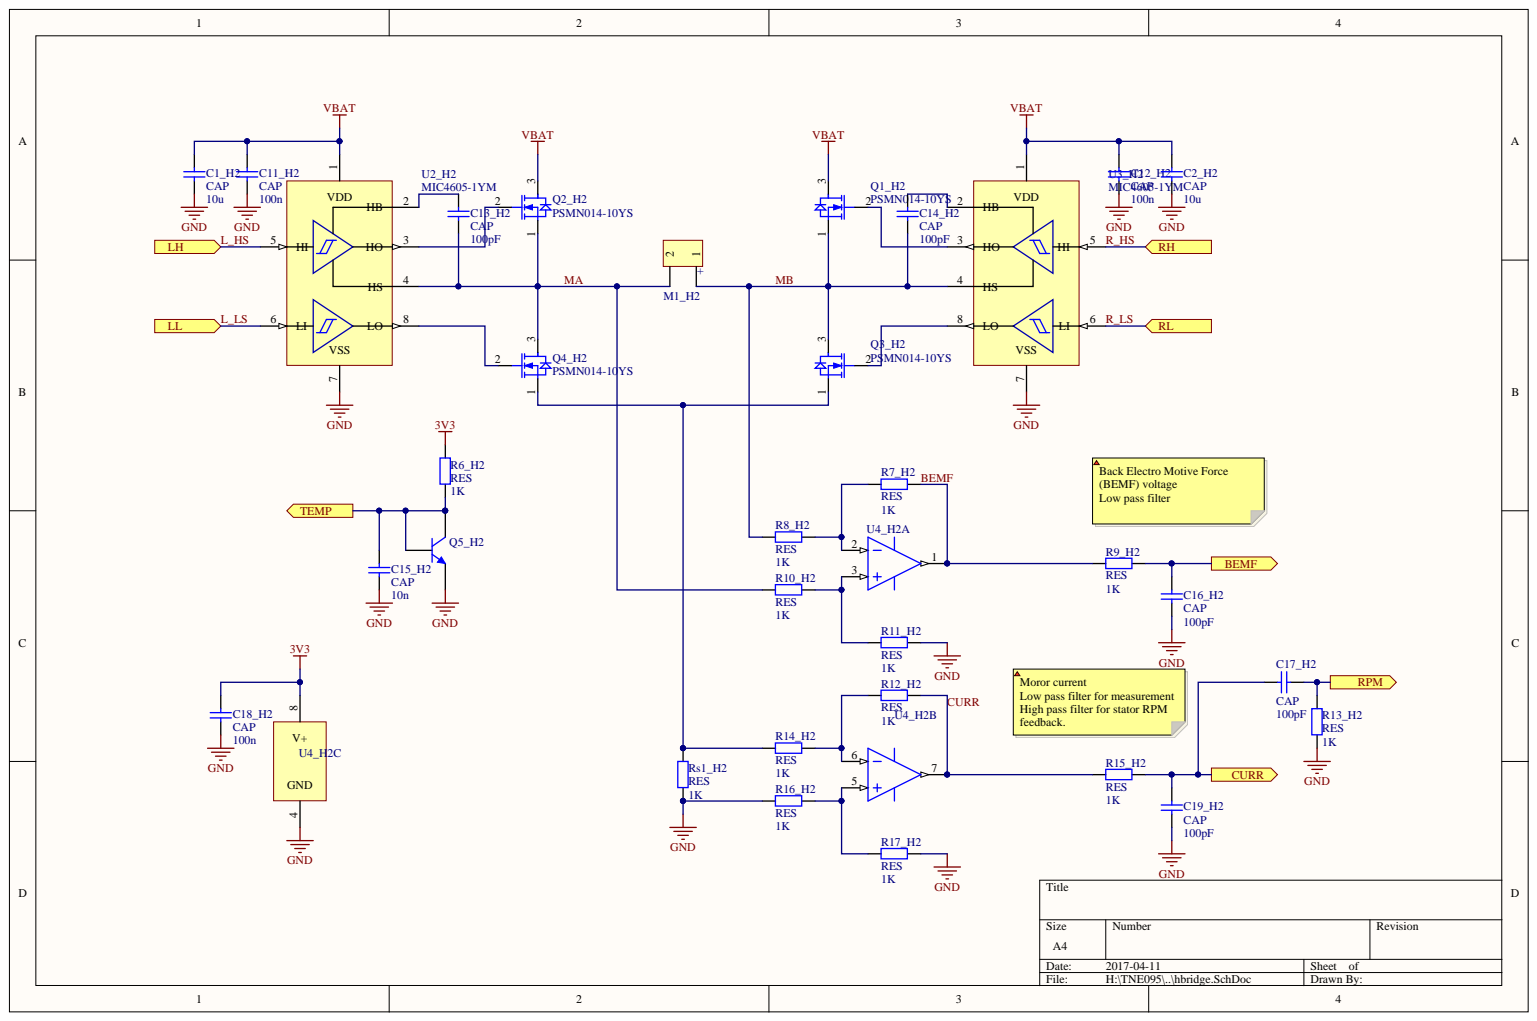
[picture p39: page 2]

Back Electro Motive Force
(BEMF) voltage
Low pass filter

Moror current
Low pass filter for measurement
High pass filter for stator RPM
feedback.

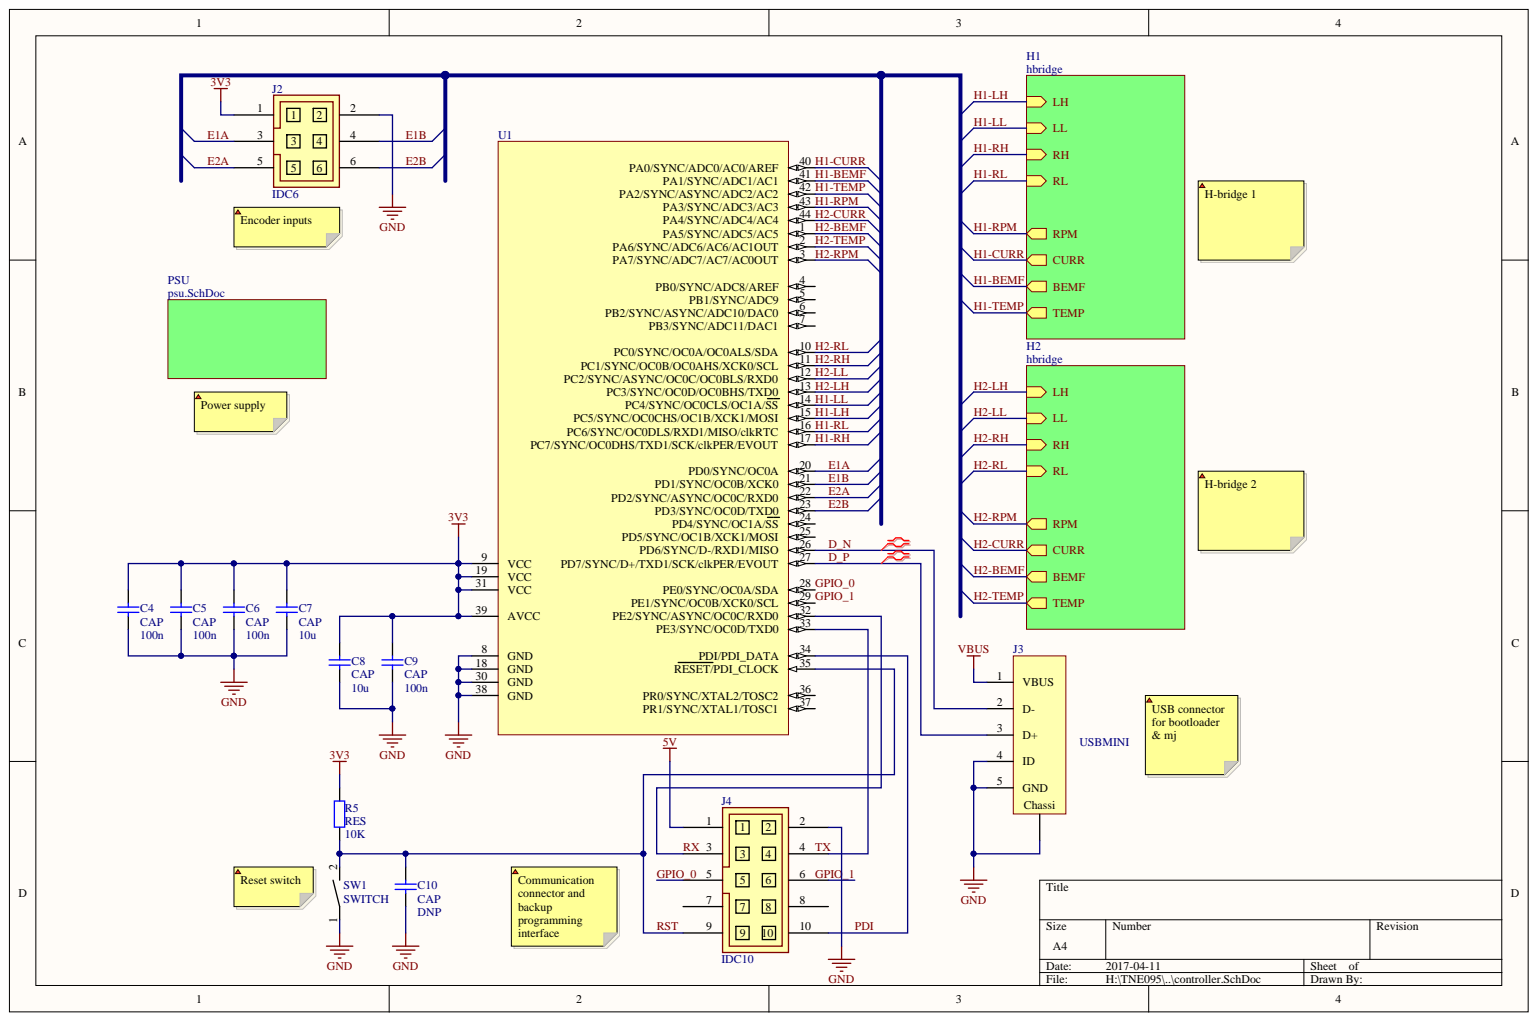
[picture p40: page 3]

E1A | H2-RL
E1B | H2-RPM

D_P | H2-BEMF

VCC 19 | | GPIO_0 GPIO_1

AVCC 39

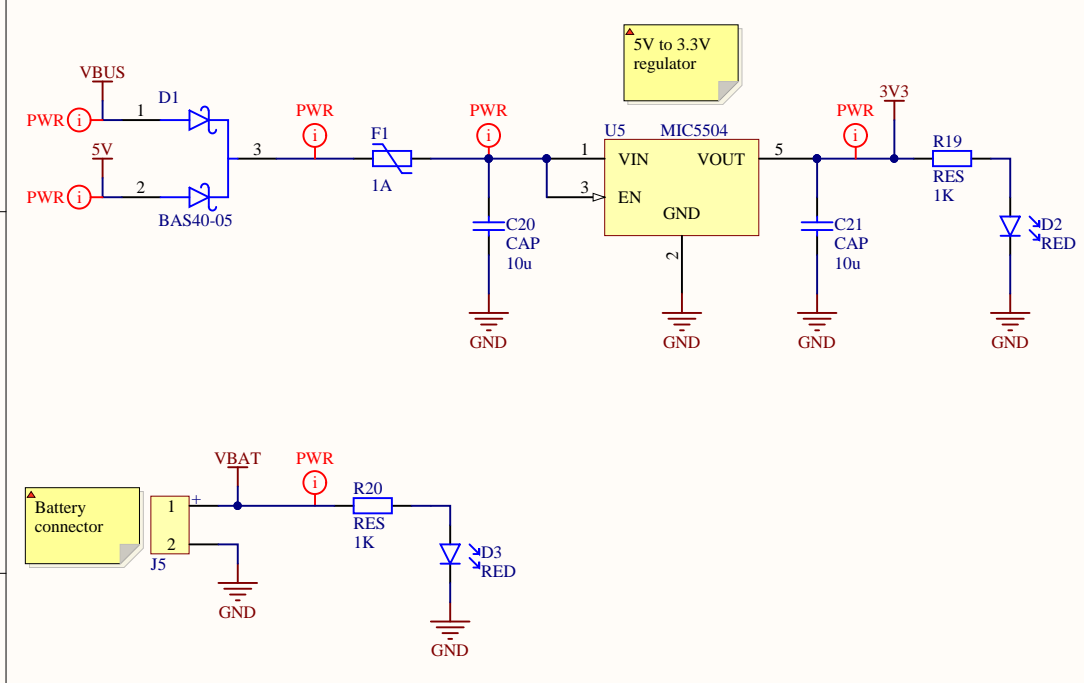
[picture p41: page 4]
