Atmelfan/Kandidat/Main_card/Schematic Prints.pdf

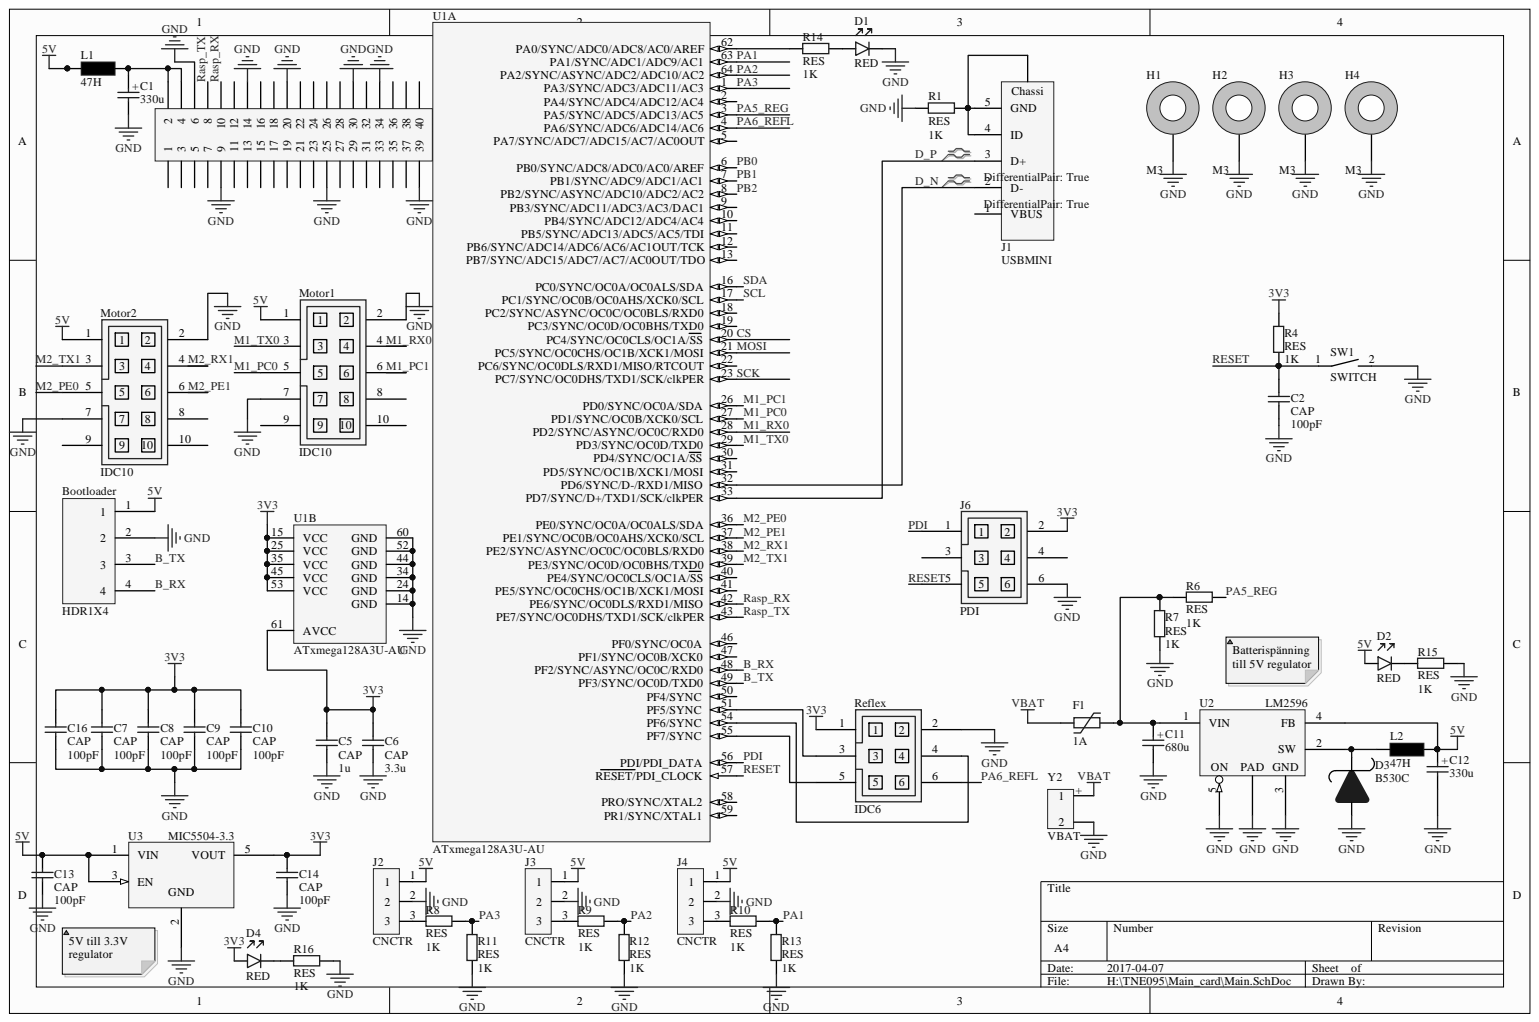
[picture p42: page 1]
