Atmelfan/Kandidat/hbridge/encoder/rpmsens.pdf

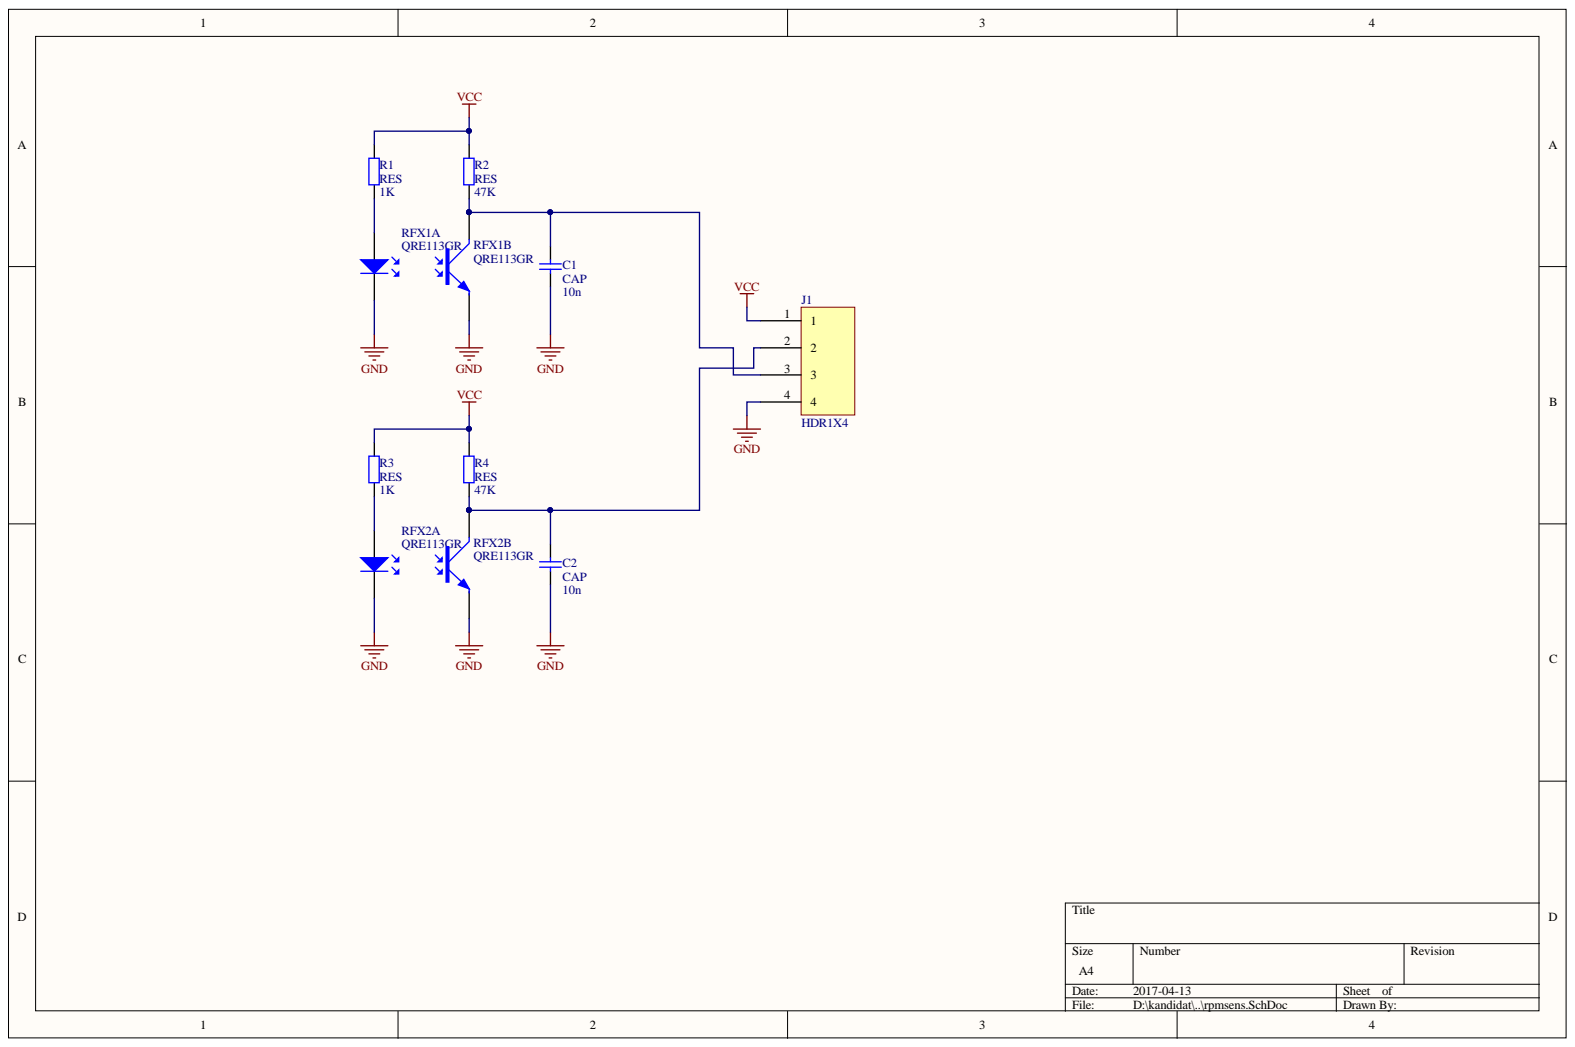
[picture p43: page 1]

Numbe r | R evision

: 2017-04-13 | She et of
File : D:\kandidat\. .\rpmsens. S chDoc | D r a wn By:
