Atmelfan/Kandidat/(list of files, drawings)

Other design files:
altiumlibs/Atmel Microcontroller AVR XMEGA/Microcontroller AVR XMEGA.PcbLib
altiumlibs/Atmel Microcontroller AVR XMEGA/Microcontroller AVR XMEGA.SchLib
altiumlibs/Miscellaneous Connectors/Miscellaneous Connectors.PcbLib
altiumlibs/Miscellaneous Connectors/Miscellaneous Connectors.SchLib
altiumlibs/mosfets.SchLib
altiumlibs/std.PcbLib
altiumlibs/std.SchLib
display/Blinkers/blinkers.PcbDoc
display/Blinkers/Blinkers.PrjPcb
display/Blinkers/blinkers.SchDoc
display/PCB_Project/595.SchLib
display/PCB_Project/displaykort.PcbDoc
display/PCB_Project/displaykort.SchDoc
display/PCB_Project/PCB_Project.PrjPcb
hbridge/encoder/encoder.PcbDoc
hbridge/encoder/encoder.PrjPcb
hbridge/encoder/encoderx4.PcbDoc
hbridge/encoder/PCB1.PcbDoc
hbridge/encoder/rpmsens.SchDoc
hbridge/H-bridge/controller.SchDoc
hbridge/H-bridge/H-bridge.PrjPcb
hbridge/H-bridge/hbridge.PcbDoc
hbridge/H-bridge/hbridge.SchDoc
hbridge/H-bridge/INDC3924X34M.PcbLib
hbridge/H-bridge/mosfets.SchLib
hbridge/H-bridge/psu.SchDoc
hbridge/H-bridge/rpmsens.SchDoc
hbridge/H-bridge/std.PcbLib
hbridge/H-bridge/std.SchLib
hbridge/H-bridge/swreg.SchLib
hbridge/pcb/hbridge/hbridge.PrjPcb
Main_card/display.PcbLib
Main_card/Display.SchDoc
Main_card/Main.SchDoc
Main_card/Main_card.PcbDoc
Main_card/Main_card.PrjPcb
Main_card/MIDOSDISP.SchLib
Passenger/passeger/passeger.PrjPcb
Passenger/passeger/Passenger.PcbDoc
Passenger/passeger/passenger.SchDoc
Passenger/passeger/plcc6.PcbLib
Passenger/passeger/plcc6.SchLib
reflex/4051.PcbLib
reflex/4051.SchLib
reflex/QRE1113.PcbLib
reflex/QRE1113.SchLib
reflex/reflex.PcbDoc
reflex/reflex.PrjPCB
reflex/reflex.SchDoc
reflex/reflextest.PcbDoc
reflex/Sheet1.SchDoc
reflex/std.PcbLib
reflex/std.SchLib
Scripts/Delphiscript Scripts/PCB/PadViaExamples.PcbDoc
Scripts/Delphiscript Scripts/PCB/PCB Iterators/Polygons.PcbDoc
Scripts/Delphiscript Scripts/SCH/Connectivity/NetInfoPrj.PrjPCB
