Atmelfan/Kandidat/hbridge/src/scpi_sensors.h

//
// Created by atmelfan on 2017-04-10.
//

#ifndef AVR_MAIN_SCPI_DISTANCE_H
#define AVR_MAIN_SCPI_DISTANCE_H

const char* scpi_distance_get0(const char* command);
const char* scpi_line_get(const char *command);
const char *scpi_battery_get(const char *command);


#endif //AVR_MAIN_SCPI_DISTANCE_H
