Atmelfan/Kandidat/hbridge/goldsrc/motors_scpi.h

//
// Created by atmelfan on 2017-04-06.
//

#ifndef AVR_CLION_MOTORS_SCPI_H
#define AVR_CLION_MOTORS_SCPI_H

/*******************CH1*******************/
const char* scpi_motor_setduty1(const char* s);
const char* scpi_motor_queryduty1(const char* s);

const char* scpi_motor_setdir1(const char* s);

const char* scpi_motor_setoff1(const char* s);

const char* scpi_motor_seton1(const char* s);



/*******************CH1*******************/
const char* scpi_motor_setduty2(const char* s);
const char* scpi_motor_queryduty2(const char* s);

const char* scpi_motor_setdir2(const char* s);


/*******************SYS*******************/

#endif //AVR_CLION_MOTORS_SCPI_H
