Atmelfan/Kandidat/(commit log)

2017-03-07 Skapade h-brygge projekt
    [hbridge.PrjPcb, hbridge.SchDoc]
2017-03-08 More stuff
    [H-bridge.PrjPcb, controller.SchDoc, hbridge.SchDoc, ipc_cap.xls, ipc_res.xls, mosfets.SchLib, std.PcbLib, std.SchLib]
2017-03-20 potato potata
    [Main.SchDoc, Main_card.PrjPcb, hbridge.SchDoc]
2017-03-20 Merge branch 'master' of http://github.com/Atmelfan/kandidat
    # Conflicts:
    # hbridge/H-bridge/History/H-bridge.~(1).PrjPcb.Zip
    [Main.SchDoc, std.PcbLib, std.SchLib]
2017-03-20 H-brygga, fixade småsaker.
    [hbridge.SchDoc, rpmsens.SchDoc]
2017-03-21 encoder m.cad
    [encoder.DXF, encoder.SLDPRT]
2017-03-22 Lade till en 1x3 connector.
    [Main.SchDoc, std.PcbLib, std.SchLib]
2017-03-22 added reflex
    [4051.PcbLib, 4051.SchLib, QRE1113.PcbLib, QRE1113.SchLib, Sheet1.SchDoc, reflex.PcbDoc, reflex.PrjPCB, reflex.SchDoc]
2017-03-22 main card stuff
    [Main.SchDoc, std.PcbLib, std.SchLib]
2017-03-22 Too little
    [H-bridge.PrjPcb, controller.SchDoc, psu.SchDoc]
2017-03-23 mini usb
    [H-bridge.PrjPcb, controller.SchDoc, hbridge.SchDoc, psu.SchDoc, std.PcbLib, std.SchLib]
2017-03-23 started display
    [595.SchLib, display.PcbLib, displaykort.SchDoc]
2017-03-23 Fixade kristall.
    [Main.SchDoc, std.PcbLib, std.SchLib]
2017-03-23 uppdated display
    [595.SchLib, MIDOSDISP.SchLib, PCB_Project.PrjPcb, display.PcbLib, displaykort.SchDoc]
2017-03-23 Lade till inköpslista.
    [Inköpslista.xlsx, Main.SchDoc]
2017-03-23 h-bridge & usb
    [controller.SchDoc, hbridge.SchDoc, psu.SchDoc]
2017-03-24 Lade till batteri-kontakt.
    [Main.SchDoc, std.PcbLib, std.SchLib]
2017-03-24 added polyfuse
    [std.SchLib]
2017-03-24 fixed holes
    [Miscellaneous Connectors.PcbLib, Miscellaneous Connectors.SchLib, controller.SchDoc, hbridge.SchDoc, psu.SchDoc, std.PcbLib]
2017-03-24 Finished hbridge schematic
    [H-bridge.PrjPcb, controller.SchDoc, hbridge.SchDoc, psu.SchDoc, rpmsens.SchDoc]
2017-03-24 Main_card typ klar.
    [Main.SchDoc, Main_card.PrjPcb]
2017-03-24 Påbörjat pcb
    [H-bridge.PrjPcb, PCB1.PcbDoc, controller.SchDoc, encoder.PcbDoc, encoder.PrjPcb, hbridge.SchDoc, psu.SchDoc, rpmsens.SchDoc]
2017-03-26 finnished display card
    [PCB_Project.PrjPcb, displaykort.PcbDoc, displaykort.SchDoc]
2017-03-27 Börjat med PCB design på huvudkortet.
    [Display.SchDoc, MIDOSDISP.SchLib, Main.SchDoc, Main_card.PcbDoc, Main_card.PrjPcb, display.PcbLib, displaykort.SchDoc]
2017-03-27 encoder pcb färdigt
    [altium_encoder.DXF, encoder.PcbDoc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]
2017-03-28 fguö.ogigptlo
    [hbridge.SLDPRT]
2017-03-28 Dag 2 av layouten på huvudkortet.
    [Main_card.PcbDoc]
2017-03-29 Typ klar med design/CAD av huvudkortet.
    [Display.SchDoc, Main.SchDoc, Main_card.PcbDoc, Main_card.PrjPcb]
2017-03-30 fixade gerbers för huvudkortet och reflex. börjat på passagerar LED kortet.
    [Main_card.PcbDoc, Main_card.PrjPcb, Passenger.PcbDoc, Sheet1.SchDoc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]
2017-03-30 Fördig med pcb
    [H-bridge.PrjPcb, controller.SchDoc, encoder.PrjPcb, encoderx4.PcbDoc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]
2017-04-04 Raspberry c++ make2
2017-04-05 CADDADE om main_card med ny processor.
    [Display.SchDoc, MIDOSDISP.SchLib, Main.SchDoc, Main_card.PcbDoc, Main_card.PrjPcb, Microcontroller AVR XMEGA.PcbLib, Microcontroller AVR XMEGA.SchLib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]
2017-04-06 Fixade reflex kortet.
    [4051.SchLib, Sheet1.SchDoc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]
2017-04-07 minifix på display.
    [Main.SchDoc, Main_card.PcbDoc, Sheet1.SchDoc, display.PcbLib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]
2017-05-05 raspberry kod
2017-05-07 Fungerande stationshållning
    [H-bridge.PrjPcb, encoder.PrjPcb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]
